YilunAllenChen/YingXao/README.md

# YingXao

Senior Capstone Design Project, Team Shouku  
ECE 4872  
Advisor: Linda Milor

## Project Documentation
All of our documentation is in a [CODA](https://coda.io/d/Senior-Design-Notebook_dczEd0e2DqA/Assignments_suUAO#_luX_1) page.
