YilunAllenChen/YingXao/YingXao_Expo/ece_server_version/download/projectsummary.docx

ECE 4871 Project Summary

Project Title | “YingXao 英招” Automatic EcoGardener

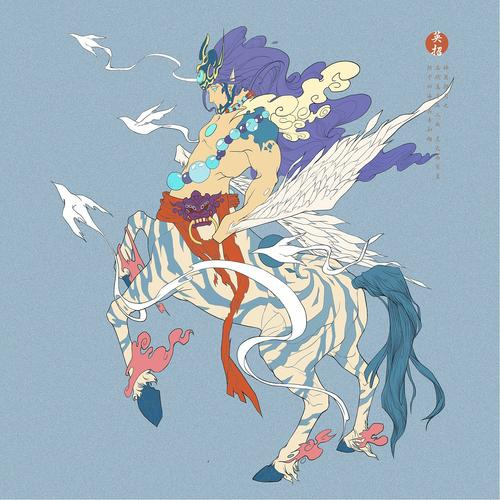
[picture p3: figure]

Project Logo
Team Members (names and majors) | Yihan Jiang (Computer Engineering)
| Yida Wang (Computer Engineering)
| Xi Li (Electrical Engineering)
| Yilun Chen (Computer Engineering)
Advisor / Section | Dr. Linda S Milor
Semester | Fall 2020 ECE 4871

Project Abstract

(250-300 words)

(10 point font, single spaced)

YingXao is embedded system design that can completely automate the process of taking care of the plant with a plan specifically tethered towards the needs of that particular species.

To achieve this, we need a low-cost low-power microcontroller unit that can sit near the vase with environment sensors (humidity, temperature, luminosity, etc) connected in order to monitor the status of the plant. We will build an internal water cycle to make save water resources and add required nutrition for plants(nitrogen, phosphorus, and potassium)

The system will be plugged into wall power and equipped with a rechargeable LiPo battery as a backup power source.

In addition, the microcontroller unit requires internet connection capabilities(Wifi module) in order to acquire data from our pre-established database where we store caring plans for different species of plants.

Microcontroller unit will be able to communicate with users through smartphone by a mobile-based UI

The end user of this product will be able to connect the device to WiFi, set the caring configuration from a web/mobile-based UI and enjoy the convenience of automatic plant caring brought by YingXao

Size of vase(Graph)

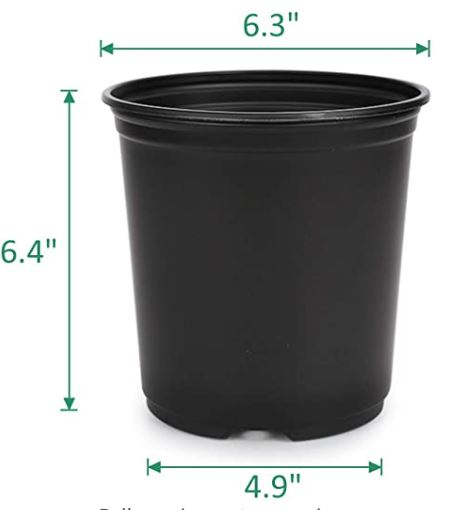
[picture p4: figure]

Figure 1. Size of plant

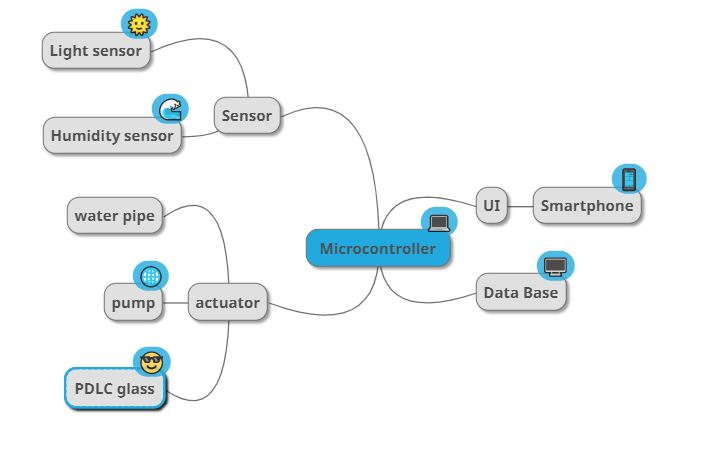
[picture p5: figure]

Figure 2. Structure of YingXao

Table of component

Component | Microcontroller | Humidity Sensor | Light Sensor | Rechargeable cells | AC Charger | Pots | Cover
Type | ESP8266 | DHT11 | 287-18001 | RCR 123A | 18650 | 07 gallon plastic pot | PDLC smart glass
Information URL | Here (https://www.espressif.com/en/products/socs/esp8266) | Here (https://www.adafruit.com/product/386) | Here (https://www.newark.com/mcm/287-18001/sensing-range-max-7m/dp/25AC5060) | Here (https://www.ebay.com/itm/8-Slot-Fast-Battery-Charger-for-Rechargeable-4-2V-Lithium-ion-RCR123A-Batteries/202795161641) | Here (https://www.joom.com/en/products/5df4b2aa28fc710101a0093c) | Here (https://www.amazon.com/GROWNEER-Container-Seedlings-Vegetables-Succulents/dp/B07QTJ1D3K) | Here (https://www.banggood.com/20x30cm-Electronic-PDLC-Smart-Glass-EGlass-Switchable-Emagic-Electroch-Film-p-1109872.html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)

Project Title
List codes and standards that significantly affect your project. Briefly describe how they influenced your design. | (10 point font, single spaced) - Institute of Electrical and Electronic Engineers (IEEE) - Coordinated with ANSI, ETSI and other standards organizations (e.g. IEEE/ANSI N42) - IEEE 802.xx standards are most cited and concentrate on telecommunications - IEEE 1666 standards concentration on software - Environmental Protection Agency (EPA), Occupational Safety and Health Administration (OSHA), Consumer Product Safety Commission (CPSC)
List at least two significant realistic design constraints that applied to your project. Briefly describe how they affected your design. | (10 point font, single spaced) 1) Power consumption 2) Size and cost of battery: the solar panel is environmentally-friendly but relatively expensive for a vase. It is important to choose a cheaper one, such as the lithium battery. 3) Glass filter for sunlight: we need to carefully choose the color of the outside cover in order to accommodate the individual sunlight requirements of plants.
Briefly explain two significant trade-offs considered in your design, including options considered and the solution chosen. | (10 point font, single spaced) Higher price will make project more effective but less attractive for potential customers More powerful MCU’s (Like Raspberry) provide additional functionalities and comparative ease to use, but are more power-hungry and costly.
Briefly describe the computing aspects of your projects, specifically identifying hardware-software tradeoffs, interfaces, and/or interactions. Complete if applicable; required if team includes CmpE majors. | (10 point font, single spaced) - The MCU reads data from environment sensors - The MCU controls actuators to adjust humidity levels / luminosity levels, etc. - The MCU pulls data from a remote database - The MCU hosts a web page as an UI - The MCU supports sleep mode for low power. - The MCU uses RTOS.

Project Title
Leadership Roles (ECE4871 & Forecasted for ECE4872) (NOTE: ECE4872 requires definition of additional leadership roles including: 1.Webmaster 2. Expo coordinator 3. Documentation | ECE 4871 Hardware Lead: Yida Wang Software Lead: Yihan Jiang Project Manager: Xi Li Documentation Administrator : Yilun Chen ECE 4872 Documentation Coordinator: Yilun Chen Project Manager: Xi Li Webmaster: Yida Wang Expo Coordinator: Yihan Jiang
International Program: Global Issues (Less than one page) (Only teams with one or more International Program participants need to complete this section) | (10 point font, single spaced) N/A
