YilunAllenChen/YingXao/YingXao_Expo/ece_server_version/download/trpxili.docx

Xi Li

Linda S Milor

Shouku, team14

Comparison of Humidity Sensor Products

Humidity Measurement and Humidity Sensor

Introduction:

Sensors are devices that acquire physical, chemical, or biological quantitative information and convert them into readable signals. For every interactive device, sensors support devices to get information from the surrounding environment. Humidity measurement is one of the most important physical properties which are closely related to the A huge variety of manufacturing, storage and testing processes are humidity-critical. Humidity sensors are used wherever the industry needs to prevent condensation, corrosion or other products that need protection. The humidity measurement is highly related to food, chemical, wood processing, electrical systems, and more products. [1][8].

Humidity Sensors types:

Current humidity sensors can be divided into two categories, absolute humidity sensors and relative humidity sensors. Absolute Humidity(AH) is calculated by ratio of mass of water vapor in air to the volume of air, while the Relative Humidity(RH) is defined as ratio of the amount of moisture in the air to the saturated moisture level that air can hold at the same temperature and pressure condition.[7] In the market, relative humidity is more popular than absolute humidity because it is simpler to make and thus cheaper. There are more types of relative humidity sensors with technology development. Since 2005, relative humidity can be categorized into 3 types, ceramic, semiconductor and organic polymer types.[2] All these three types of sensors measure changes in the physical and electrical properties when the atmospheric humidity condition changed.The ceramic type of sensor based on metal oxides has several advantages compared to other types in thermal capability, physical stability, and resistance to chemical reaction. [2] Water vapour is normally invisible, and behaves like a gas[8], so the humidity measurement of hygrometer type of sensors measures humidity by electrical impedance, conductance, because of the adsorption of water molecules of Impedance-sensitive type material. For instance, the polyimide layers with different thickness and morphologies will change its capacitive with respect to change in humidity[3], so that the ceramic type humidity sensor has two types, resistive type and capacitive type.

Among different types of sensors discussed above, in general, ceramic and semiconductor type of humidity sensors usually cost lower than other types, but this type can’t take the polymer as sensing material. Thin or thick film fabrication processes can take the polymer as sensing material but they cost higher than ceramic fabrication.

Commercial applications of Humidity measurement technology:

Most products of humidity sensors in the market are relative humidity sensors. Here is the comparison between three of the most popular RH sensors for : HS1101LF, DHT11 and HIH-4000-001.

HS1101LF has the highest price-performance ratio. it has the cheapest which only costs $5.9, and it has a wider operating temperature range and storage temperature range, both -60 to 140 °C, compared to the other two. It also has the widest humidity measurement range, from 0% -100%RH.[4]

HIH-4000-001 has similar measurement and storage temperature range, but it has the highest price among these three sensors. HIH-4000-001 costs $23.34. However, it is resistive to chemical reaction. This sensor can work properly under most application hazards, such as dust, oil, or environmental chemicals.This characteristic allows HIH-4000-001 to be used in unideal working environments.[6]

Another competing product is DHT11. DHT11 has an immediate price, but it has a narrow range of operating temperature, storage temperature. Its humidity measurement range is also narrow, only from 20-90%RH. However, this sensor has an embedded 8-bit microcontroller so that it has compatibility with microcontroller products. It’s datasheet provides users with clear wire connection and its communication protocol. [5]

Implementation of capacitive RH sensors:

There are so many types of humidity sensors and each of them has a unique fabrication process, so discussion here will only include the most popular type, the capacitive RH sensor. There are two typical configurations of capacitive humidity sensors, a sandwiched structure with two electrode surfaces on each side, or an interdigitated structure with comb electrodes. The two metal electrodes are deposited on the substrate and coated with a thin film layer of a dielectric polymer or a porous ceramic metal oxide. In the sandwich configuration, the upper electrode is always a water vapour permeable film[9]. There is a humidity sensitive polymer between two electrodes. Lead wires will be connected to the lower electrode so that the changed signal can be transmitted through wires

[1] Drexhage, P. A. U. L. "Effect of humidity and condensation on power electronics systems." Semikron Application Note NA (2016): 16-001.

[2] Farahani, H., Wagiran, R. and Hamidon, M., 2020. Humidity Sensors Principle, Mechanism, And Fabrication Technologies: A Comprehensive Review.

[3] Boudaden, J., Steinmaßl, M., Endres, H., Drost, A., Eisele, I., Kutter, C. and Müller-Buschbaum, P., 2020. Polyimide-Based Capacitive Humidity Sensor.

[4] TE Connectivity, “Relative Humidity Sensor”, HS1101LF Datasheet, September 2015 [Online]. Available: https://www.te.com/commerce/DocumentDelivery/DDEController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

[5] Adafruit, “Humidity and Temperature Sensor”, DHT11 Datasheet, September 2020 [Online]. Available: https://www.osepp.com/downloads/pdf/DHT11-Technical-Data-Sheet-Translated-Version.pdf

[6] [4]Alliedelec.com, 2020. [Online]. Available: https://www.alliedelec.com/m/d/366682f71f67784981f9126133e1d1b1.pdf. [Accessed: 09- Oct- 2020].

[7]"Humidity measurement", Slideshare.net, 2020. [Online]. Available: https://www.slideshare.net/MohitSinghRajput/humidity-measurement. [Accessed: 09- Oct- 2020].

[8]S. Bell,”The Beginner’s Guide to Humidity”, Rotronic.com, 2012. [Online]. Available: https://www.rotronic.com/media/productattachments/files/b/e/beginners_guide_to_humidity_measurement_v0_1.pdf. [Accessed: 09- Oct- 2020].

[9]R. Fenner and E. Zdankiewicz, "Micromachined water vapor sensors: a review of sensing technologies," in IEEE Sensors Journal, vol. 1, no. 4, pp. 309-317, Dec. 2001, doi: 10.1109/7361.983470.
