YilunAllenChen/YingXao/YingXao_Expo/ece_server_version/download/proposalpresentation.pdf

# “YingXao” Automatic EcoGardener

ECE 4872 Senior Design Project Proposal Presentation

Presenter: Yilun Chen, Yida Wang, Xi Li, Yihan Jiang

# Meet Our Team

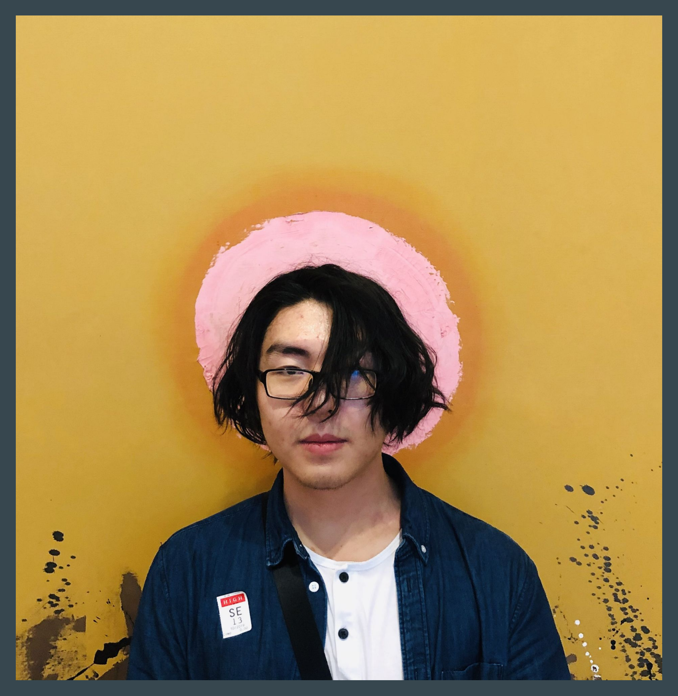
[picture p6: figure]
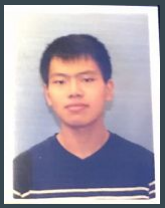
[picture p7: figure]

Hardware Lead: Yida Wang

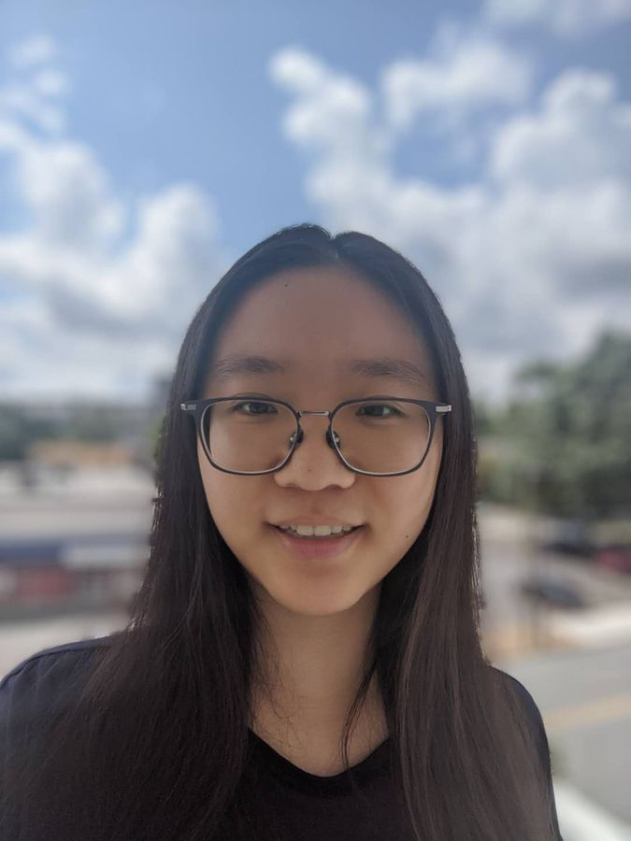
[picture p8: figure]
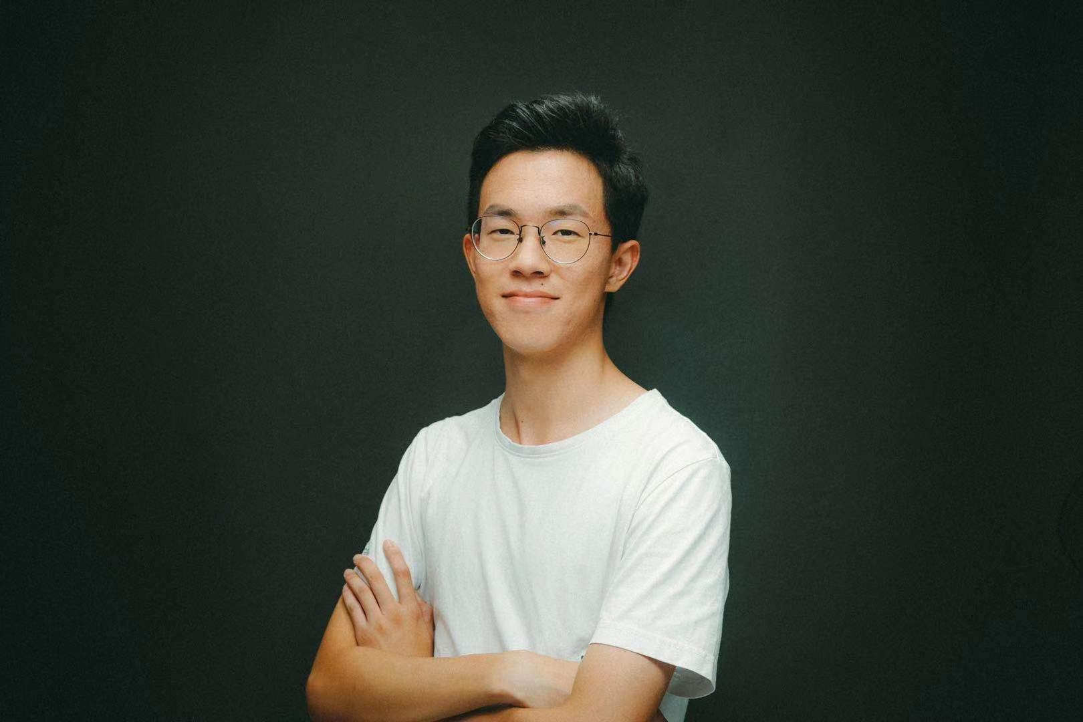
[picture p9: figure]

Software Lead: Yihan Jiang | Project Manager: Xi Li

# Motivation

### - Smart Gardening - Existing products:

- Too expensive : $2,500+ per unit
- Use artificial lighting. Not env-friendly
- Too big. Not portable

### - We also want it to:

- Constantly improve its gardening plans

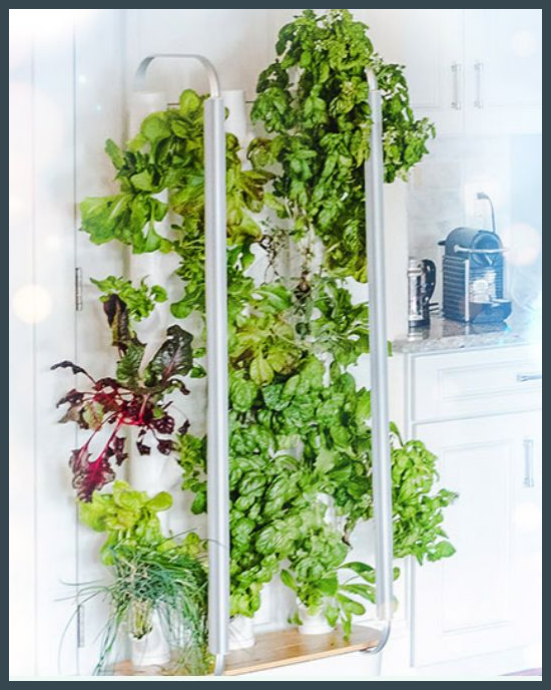
[picture p10: figure]

- Better user-plant interaction | https://mygardyn.com/

# 30,000 Ft High-level Design

### - Interplay of software and hardware

- Physical Device
- Interact with sensors and actuators
- Cloud Service
- Provides gardening plans
- App
- Provides an interaction/monitoring interface

### - Project goals

- Users don’t need to take care of the plants themselves
- Smooth and easy setup workflow
- Unit cost below $100

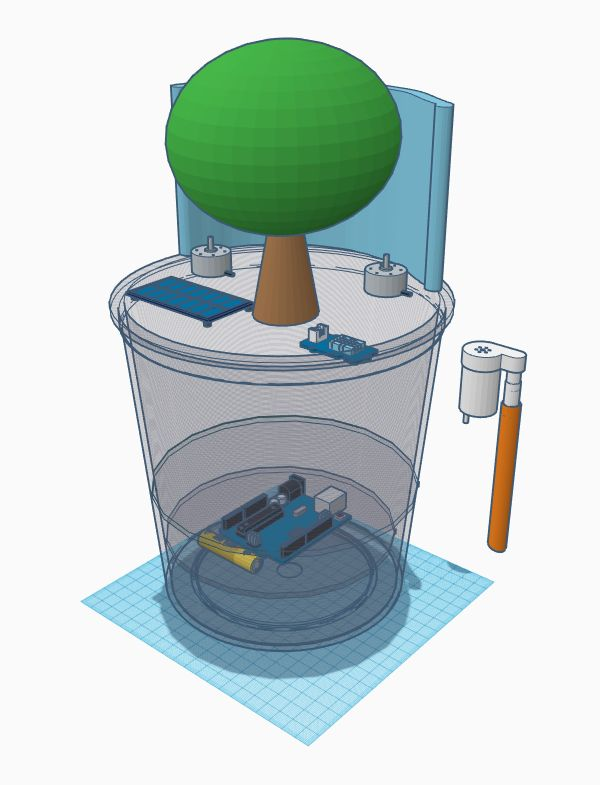
[picture p11: figure]

Picture: Conceptual Design of YingXao

# Tech Specs

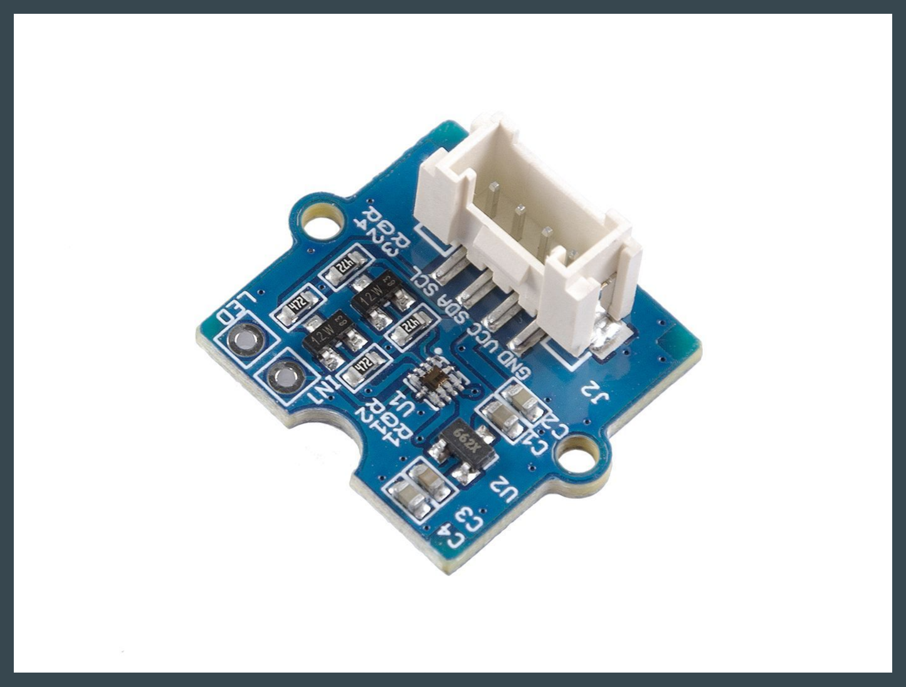
[picture p12: figure]

### - Raspberry Pi Zero W

- Fast processing speed, low cost and high compatibility
- Bluetooth and internet

### - DHT11 basic temperature-humidity sensor

- Ultra low cost and simply

### - Grove - Sunlight Sensor

- Wide spectrum detection range and detect sunlight directly

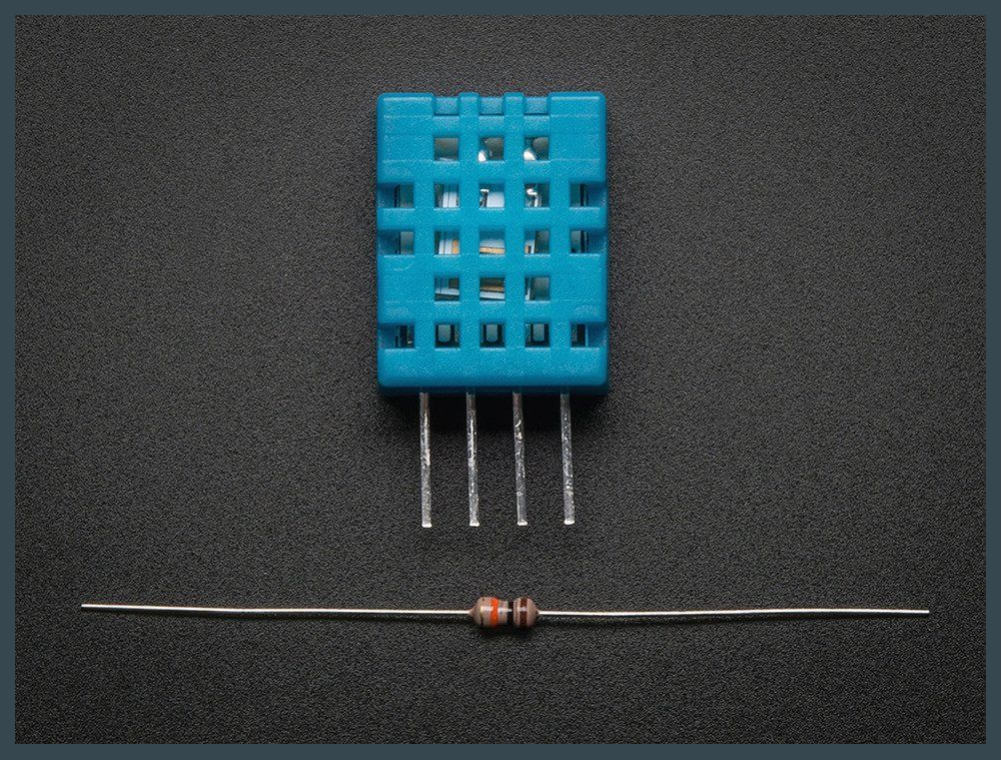
[picture p13: figure]
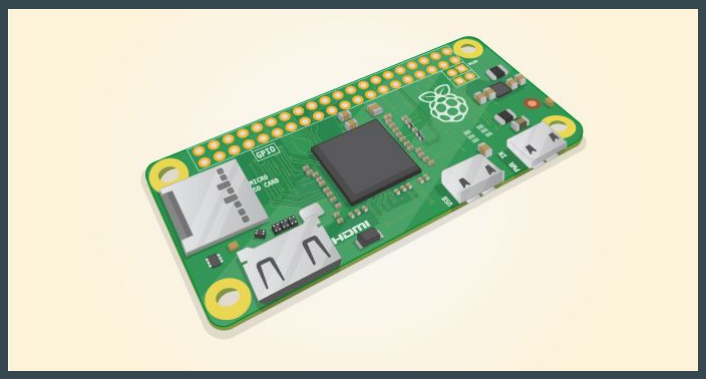
[picture p14: figure]

# Design Approach

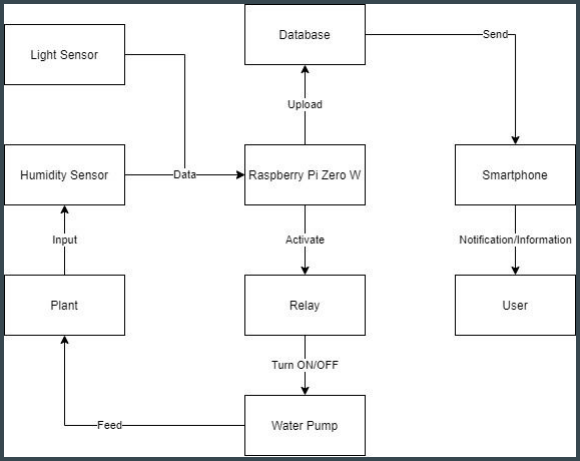
[picture p15: figure]

### - Sensing

### Light and Humidity

### - Control

### Pump and light blocking

### - Communication

### Pi zero and App

# Conceptual UI of App

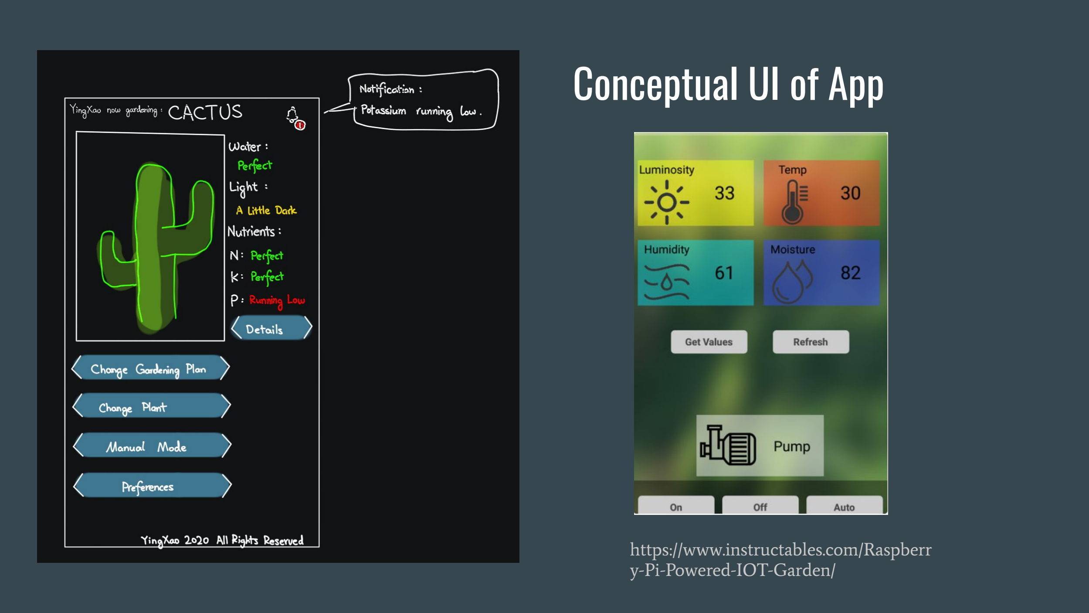
[picture p16: page 7]

https://www.instructables.com/Raspberry-Pi-Powered-IOT-Garden/

# Cost

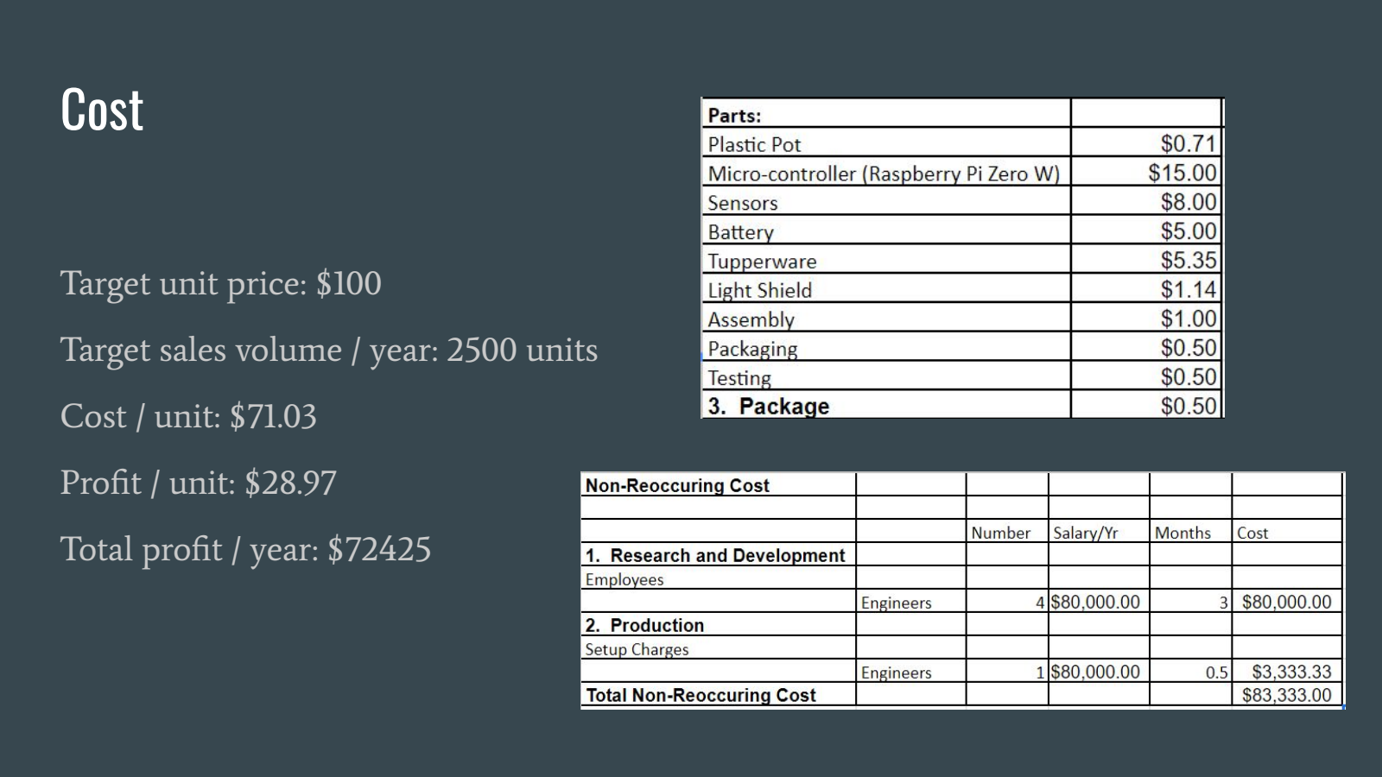
[picture p17: page 8]

### Target unit price: $100 Target sales volume / year: 2500 units Cost / unit: $71.03 Profit / unit: $28.97 Total profit / year: $72425

# Schedules and Milestones

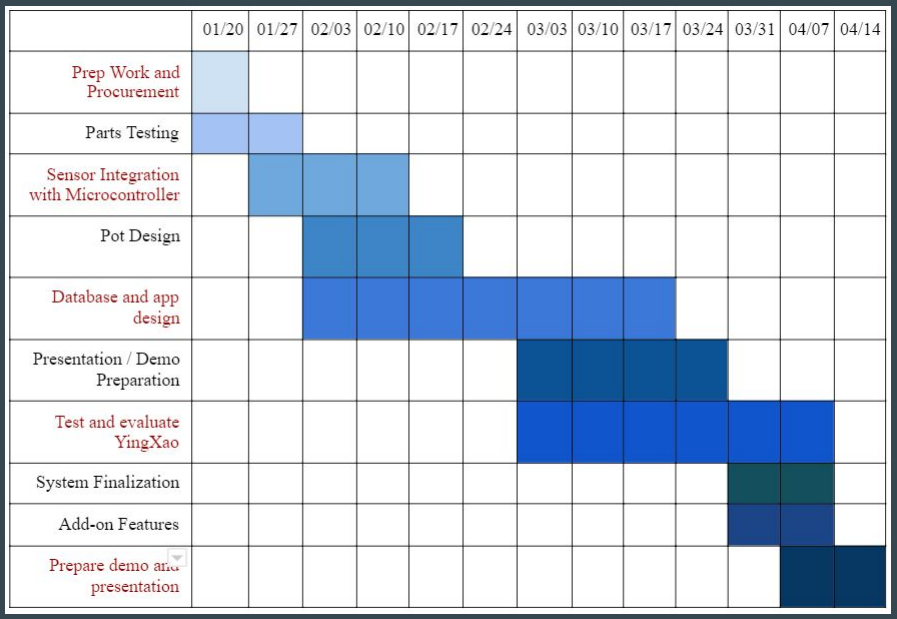
[picture p18: figure]

# Critical Path

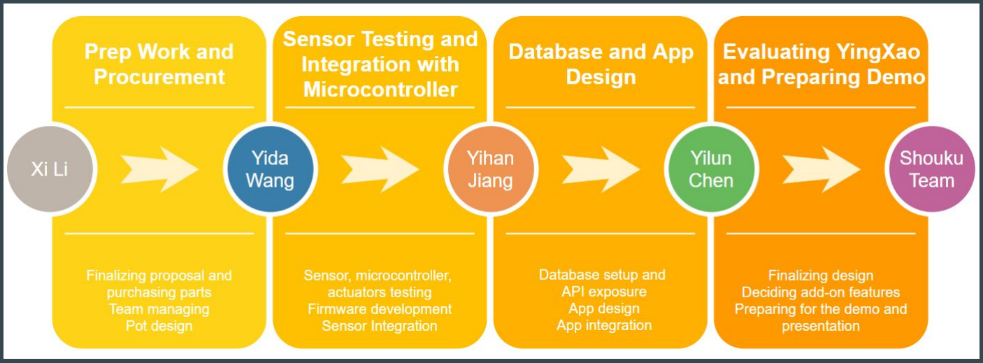
[picture p19: figure]

# Project Demo

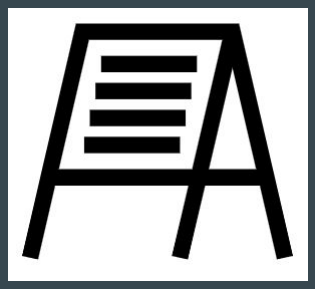
[picture p20: figure]
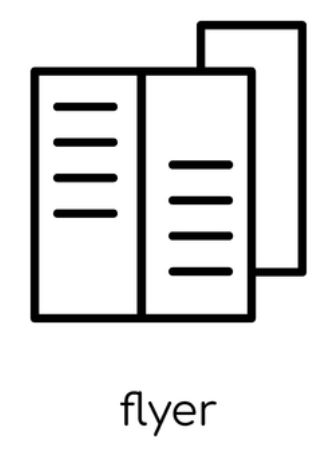
[picture p21: figure]

https://eu.clipdealer.com/vector/media

- What will we present?
Physical body of the gardener & the app that monitors the gardener
- How will we present?
Poster, Flyer -> Design overview and concept map Live demonstration -> Specific functions
1. App Setting
2. Sensor Reading
3. Pump and Light Shielding

# Thank you!
