YilunAllenChen/YingXao/YingXao_Software/Block Diagram.pdf

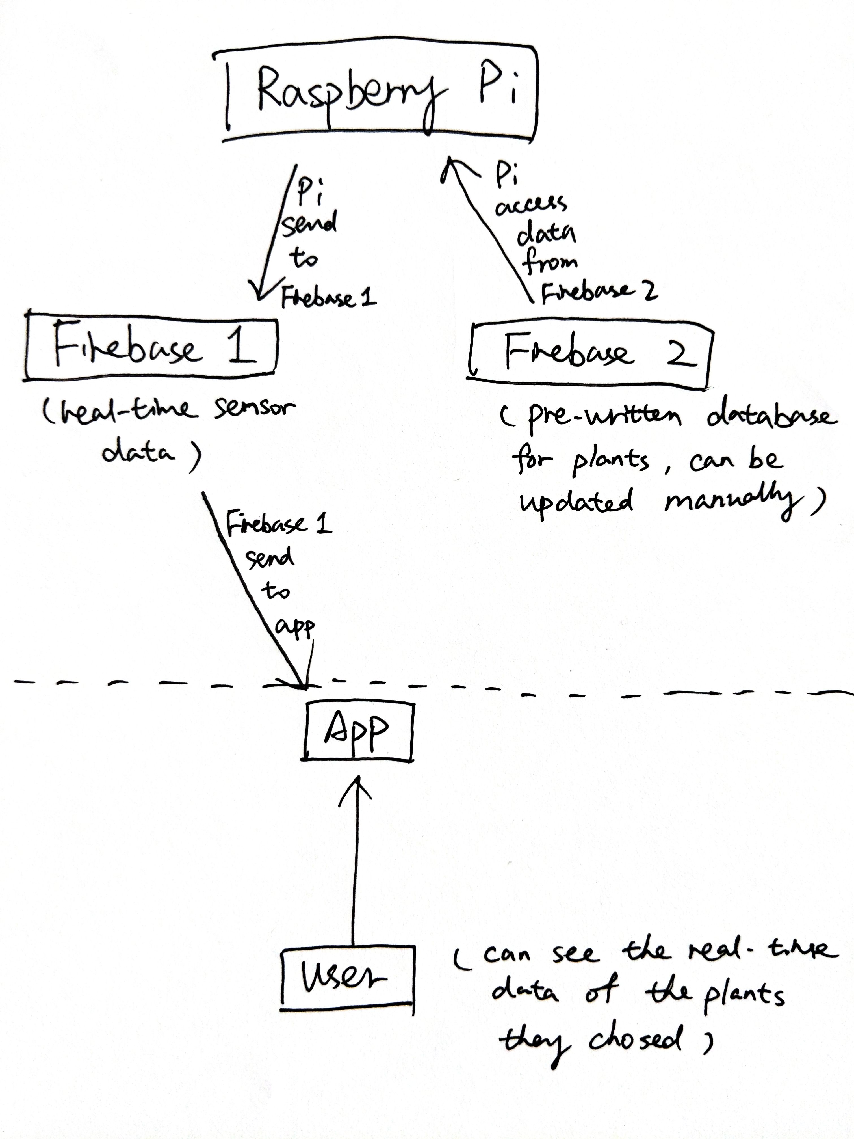
[picture p22: page 1]
