YilunAllenChen/YingXao/YingXao_Expo/ece_server_version/3dprinting.png

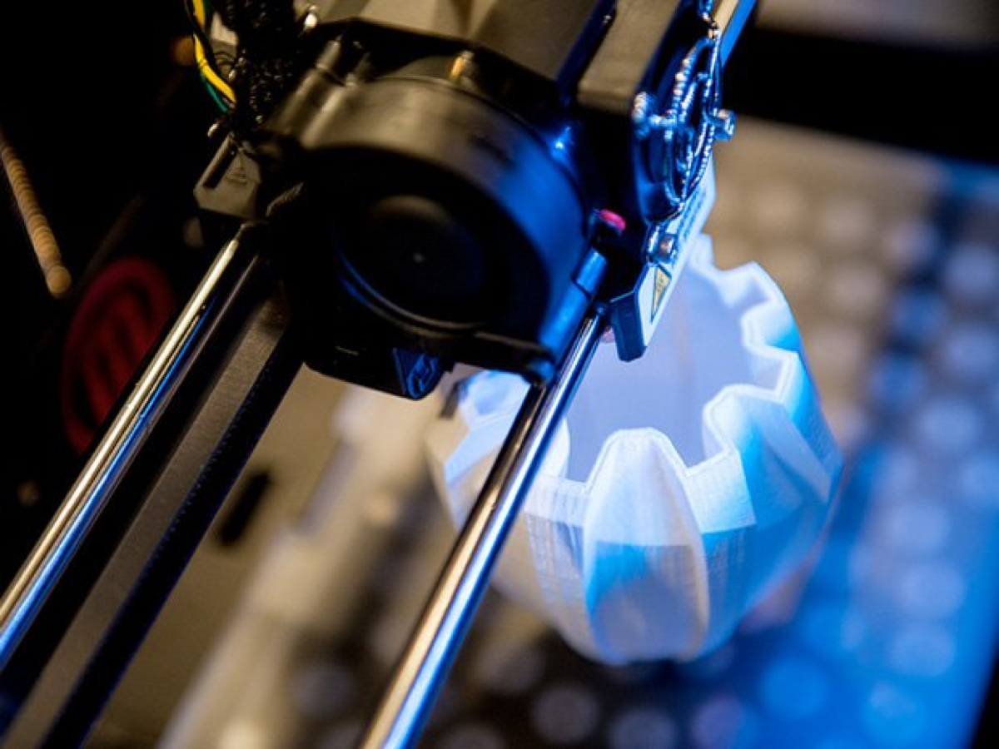
YingXao_Expo/ece_server_version/3dprinting.png
