YilunAllenChen/YingXao/YingXao_Expo/ece_server_version/3dprinting_wallpaper.jpg

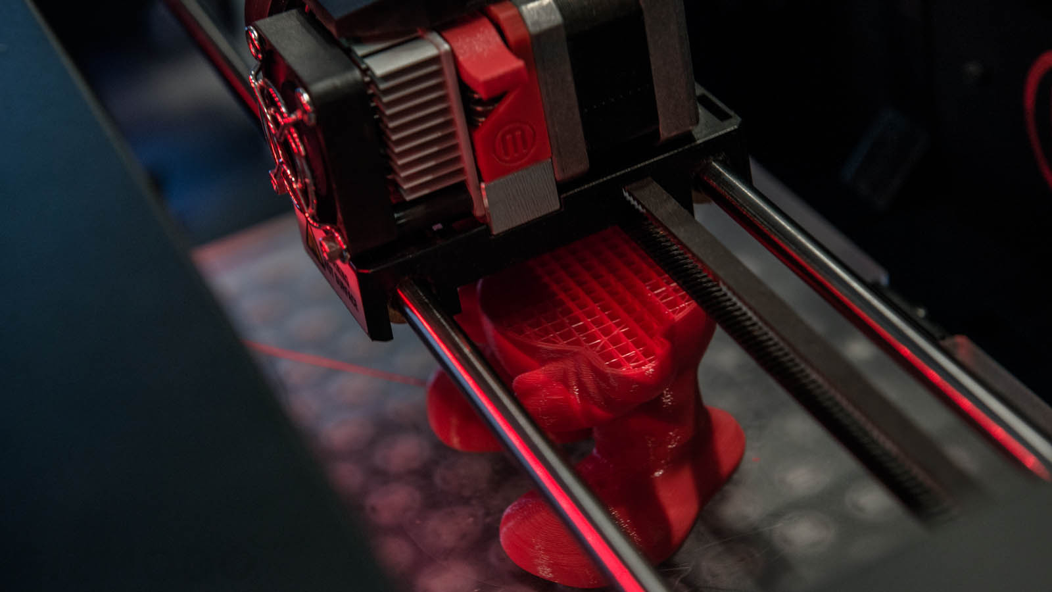
YingXao_Expo/ece_server_version/3dprinting_wallpaper.jpg
