YilunAllenChen/YingXao/YingXao_Expo/ece_server_version/black_backpack.jpg

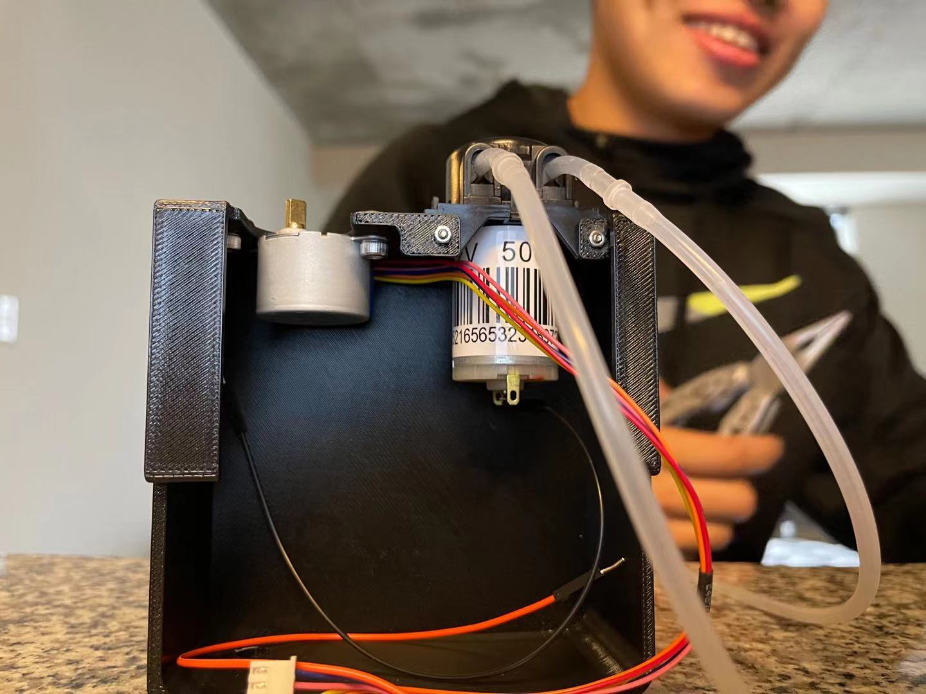
YingXao_Expo/ece_server_version/black_backpack.jpg
