YilunAllenChen/YingXao/YingXao_Expo/ece_server_version/cloud_computing.jpg

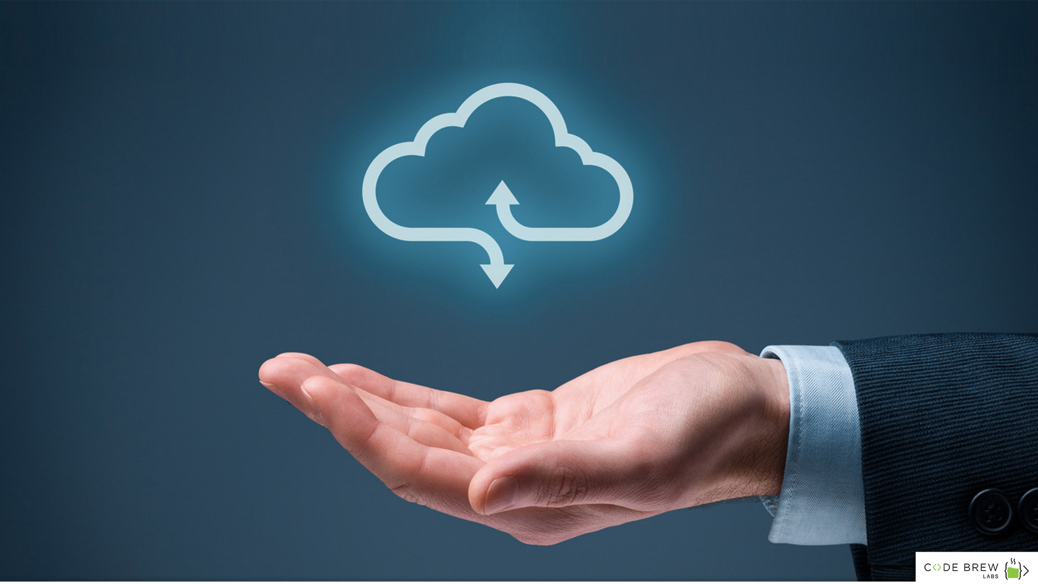
YingXao_Expo/ece_server_version/cloud_computing.jpg
