YilunAllenChen/YingXao/YingXao_Expo/ece_server_version/cloudcomputing.jpg

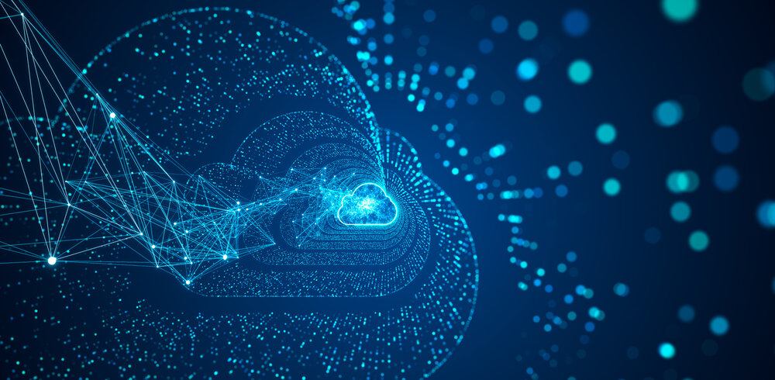
YingXao_Expo/ece_server_version/cloudcomputing.jpg
