YilunAllenChen/YingXao/YingXao_Expo/ece_server_version/cross_platform.png

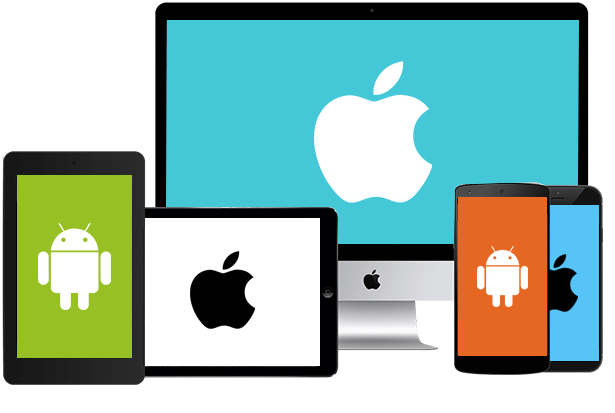
YingXao_Expo/ece_server_version/cross_platform.png
