YilunAllenChen/YingXao/YingXao_Expo/ece_server_version/download_center.jpg

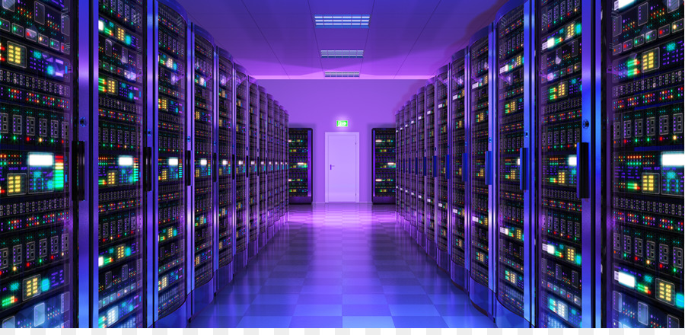
YingXao_Expo/ece_server_version/download_center.jpg
