YilunAllenChen/YingXao/YingXao_Expo/ece_server_version/electronics.jpg

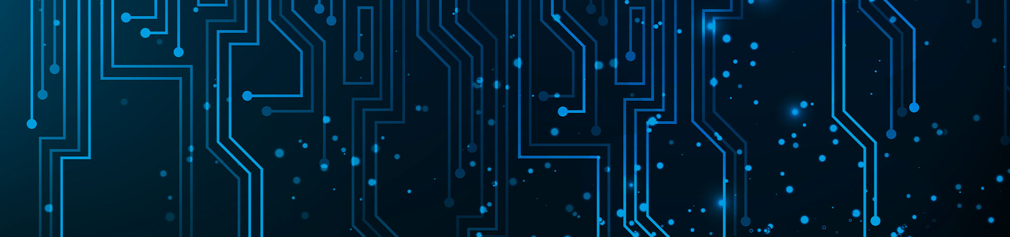
YingXao_Expo/ece_server_version/electronics.jpg
