YilunAllenChen/YingXao/YingXao_Expo/ece_server_version/electronics.png

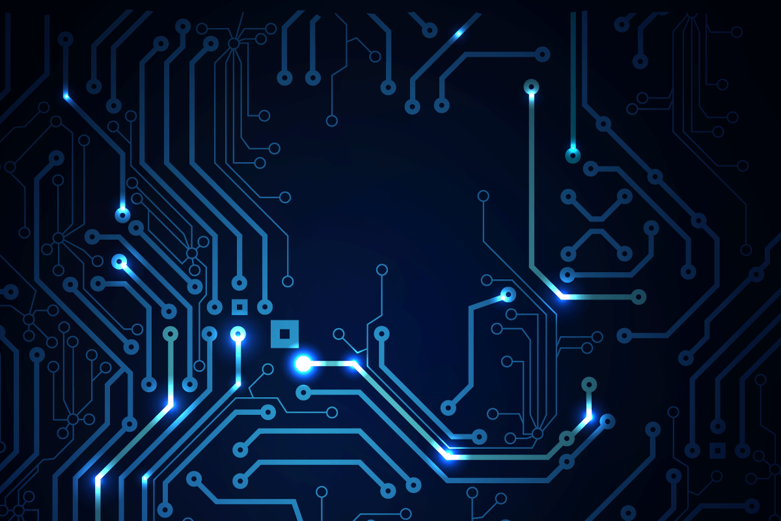
YingXao_Expo/ece_server_version/electronics.png
