YilunAllenChen/YingXao/YingXao_Expo/ece_server_version/embedded.jpg

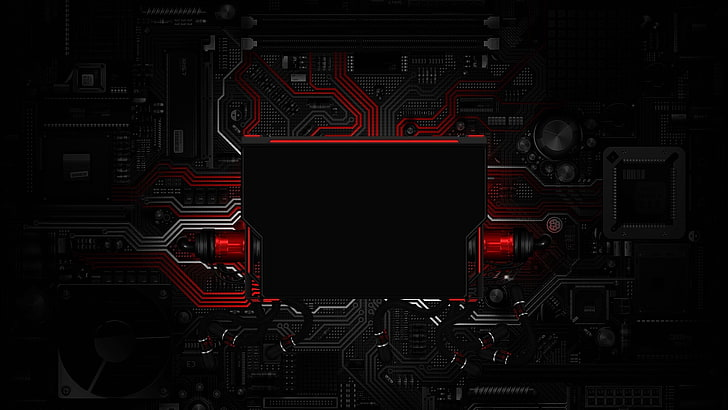
YingXao_Expo/ece_server_version/embedded.jpg
