YilunAllenChen/YingXao/YingXao_Expo/ece_server_version/mobile_app.jpg

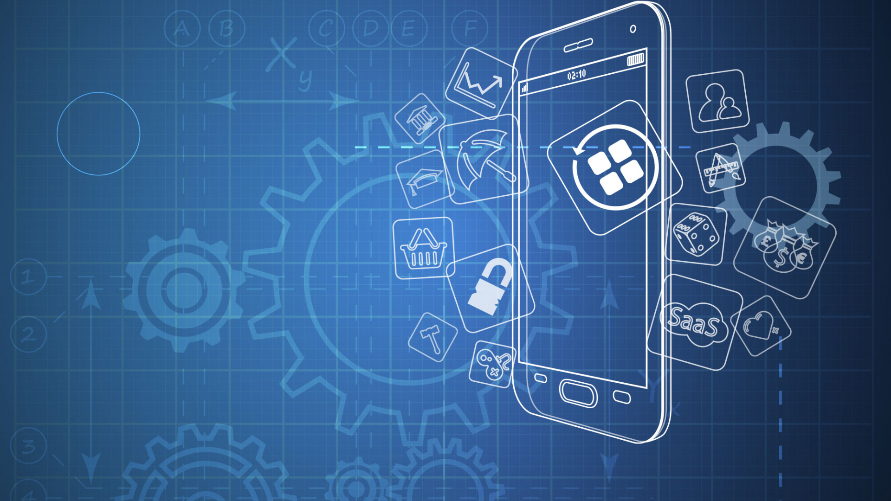
YingXao_Expo/ece_server_version/mobile_app.jpg
