YilunAllenChen/YingXao/YingXao_Expo/ece_server_version/presentation_cover.png

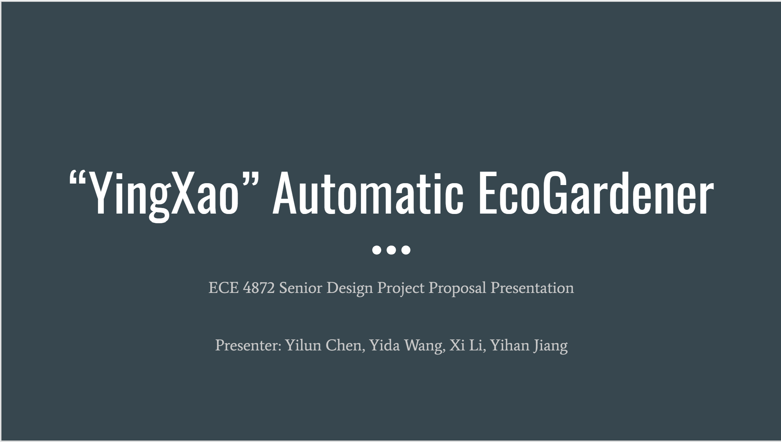
YingXao_Expo/ece_server_version/presentation_cover.png
