YilunAllenChen/YingXao/YingXao_Expo/ece_server_version/sensors.jpg

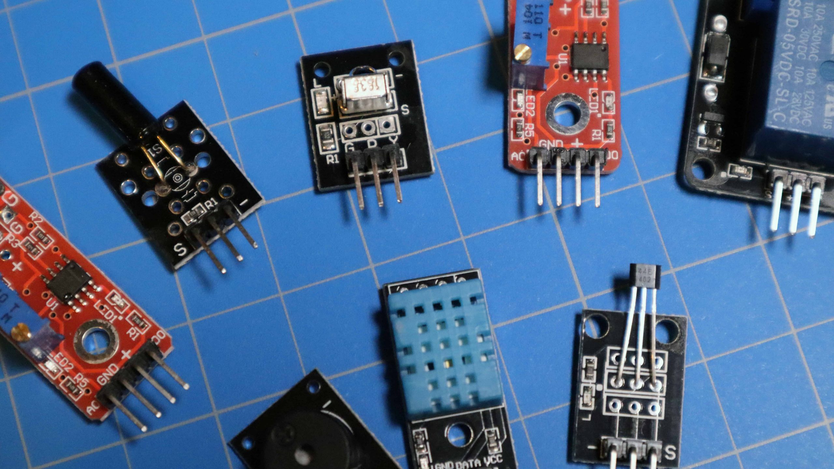
YingXao_Expo/ece_server_version/sensors.jpg
