YilunAllenChen/YingXao/YingXao_Expo/ece_server_version/sw_arch.png

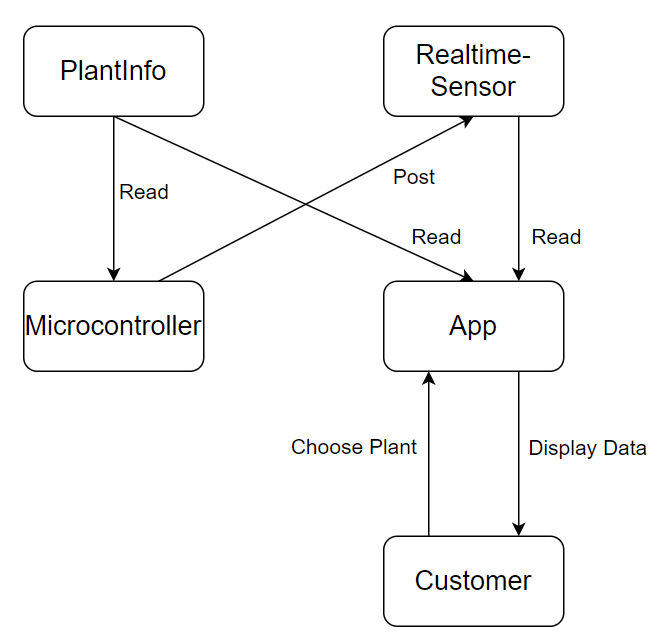
YingXao_Expo/ece_server_version/sw_arch.png
