YilunAllenChen/YingXao/YingXao_Expo/ece_server_version/sw_workflow.png

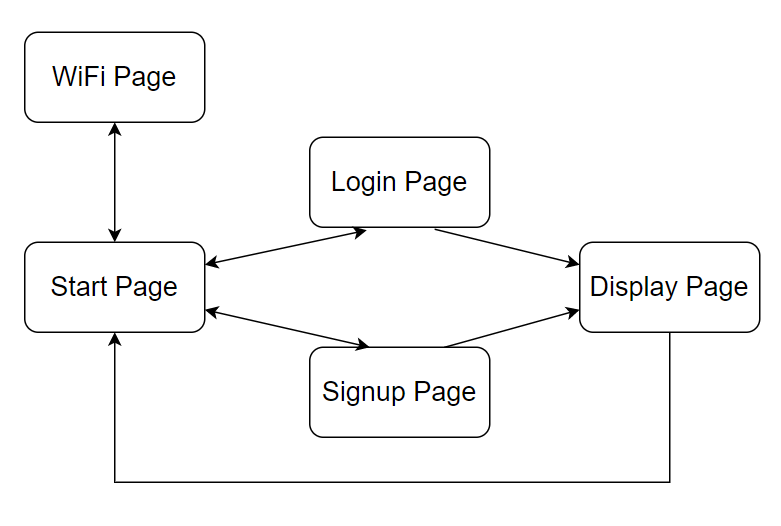
YingXao_Expo/ece_server_version/sw_workflow.png
