YilunAllenChen/YingXao/YingXao_Expo/ece_server_version/team.jpg

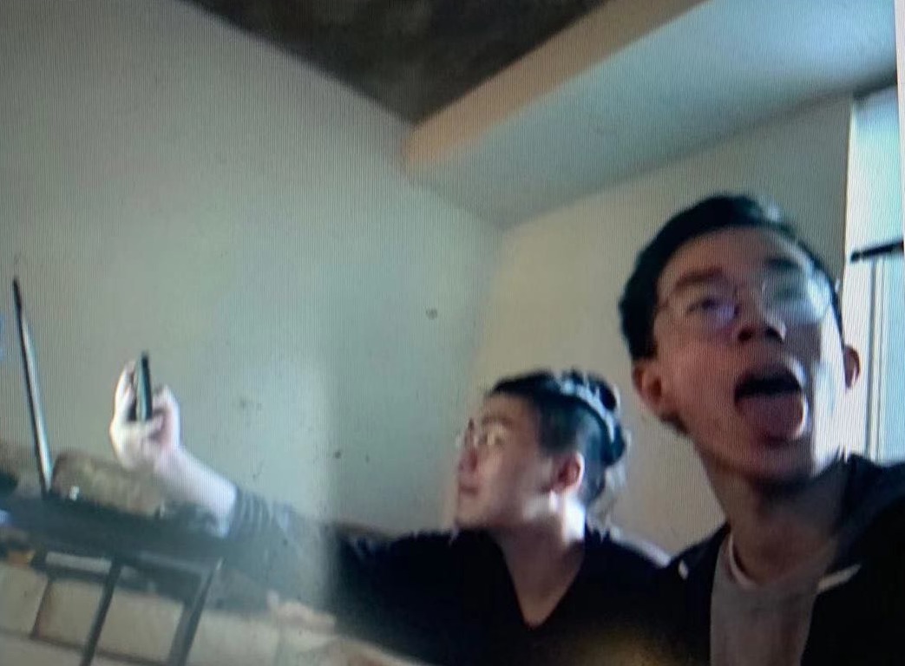
YingXao_Expo/ece_server_version/team.jpg
