YilunAllenChen/YingXao/YingXao_Expo/ece_server_version/yihan.png

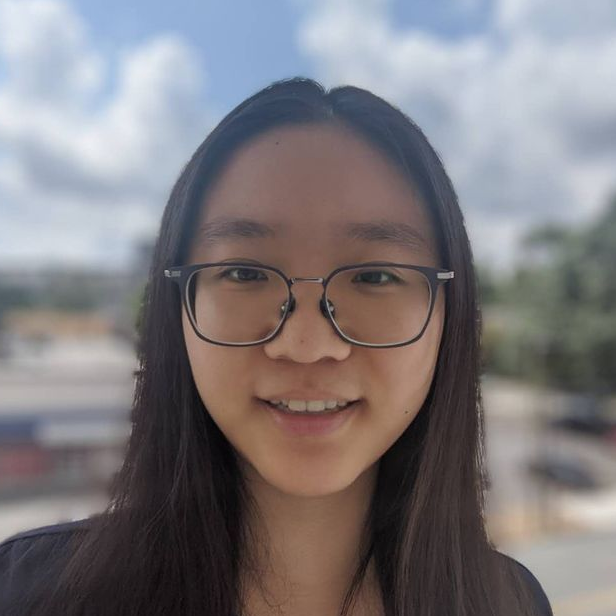
YingXao_Expo/ece_server_version/yihan.png
