YilunAllenChen/YingXao/YingXao_Expo/ece_server_version/yilun.jpg

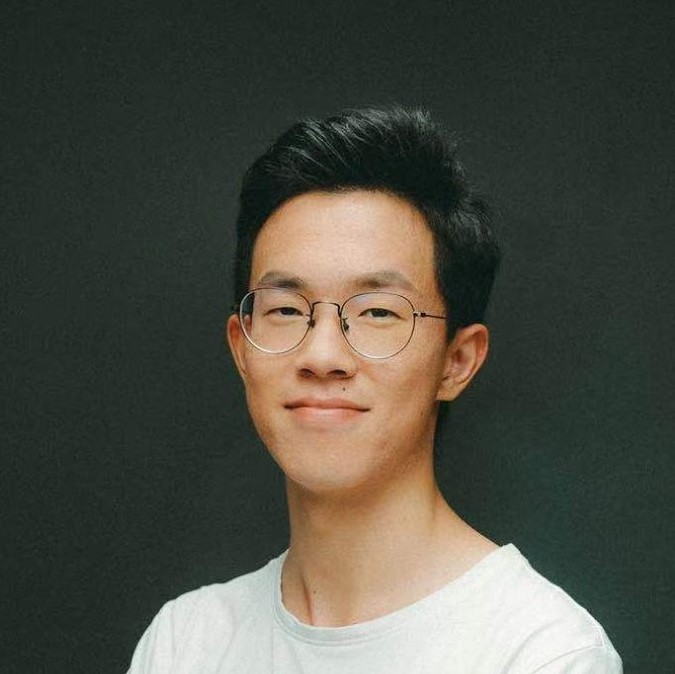
YingXao_Expo/ece_server_version/yilun.jpg
