YilunAllenChen/YingXao/YingXao_Expo/ece_server_version/yingxao_app_wifi.PNG

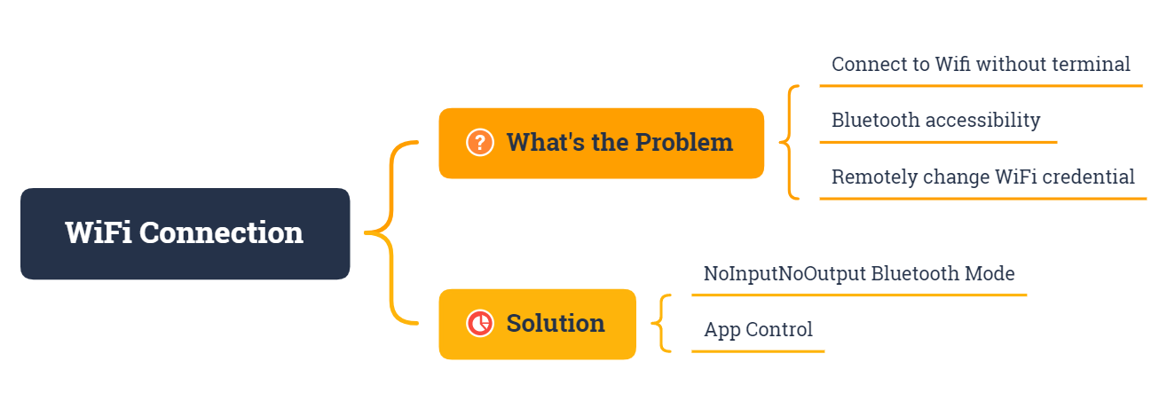
YingXao_Expo/ece_server_version/yingxao_app_wifi.PNG
