YilunAllenChen/YingXao/YingXao_Mechanical/Printable/SolarPanel_v1.stl

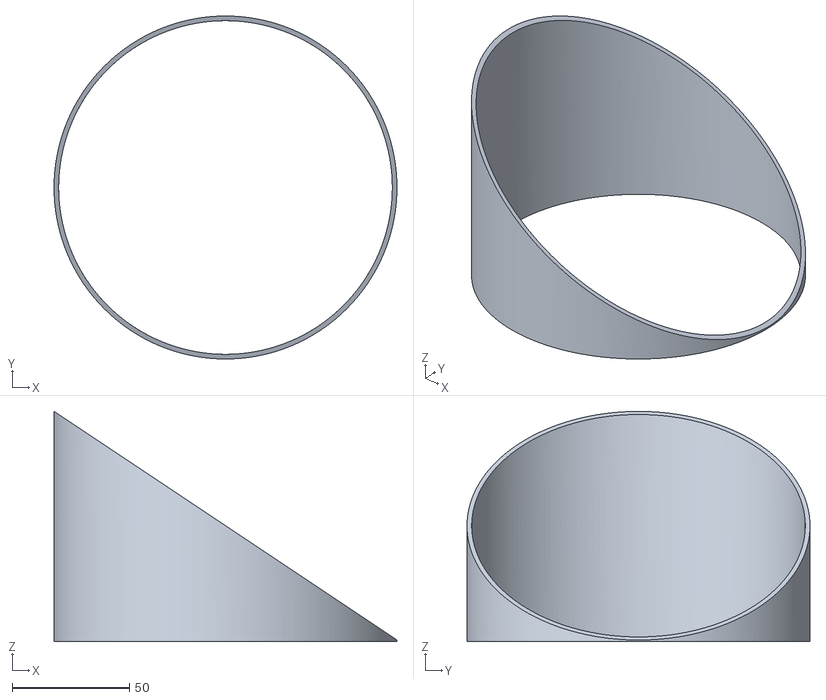
[picture p48: CAD file, 2021-03-14]
YingXao_Mechanical/Printable/SolarPanel_v1.stl
146.0 x 146.0 x 98.0
