YilunAllenChen/YingXao/YingXao_Mechanical/Printable/SolarGearRingWithBlind.stl

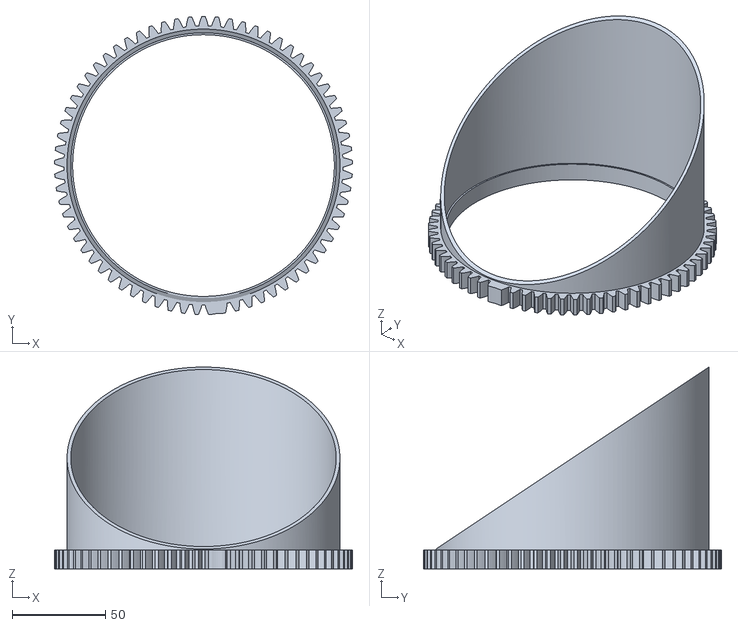
[picture p49: CAD file, 2021-03-14]
YingXao_Mechanical/Printable/SolarGearRingWithBlind.stl
159.5 x 159.5 x 108.0
