YilunAllenChen/YingXao/YingXao_Mechanical/Printable/SolarGearDriver_v13.stl

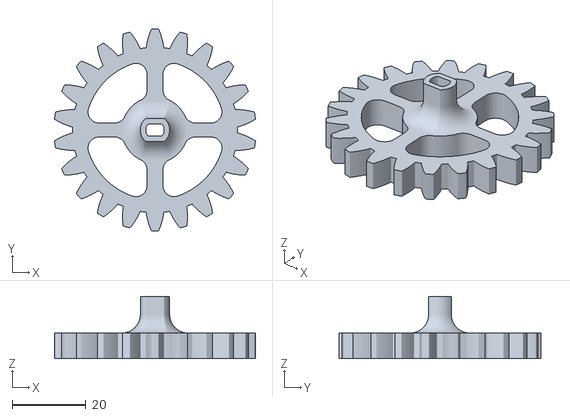
[picture p50: CAD file, 2021-03-14]
YingXao_Mechanical/Printable/SolarGearDriver_v13.stl
54.7 x 55.0 x 17.0
