YilunAllenChen/YingXao/YingXao_Mechanical/Printable/SolarGearBearing_v6.stl

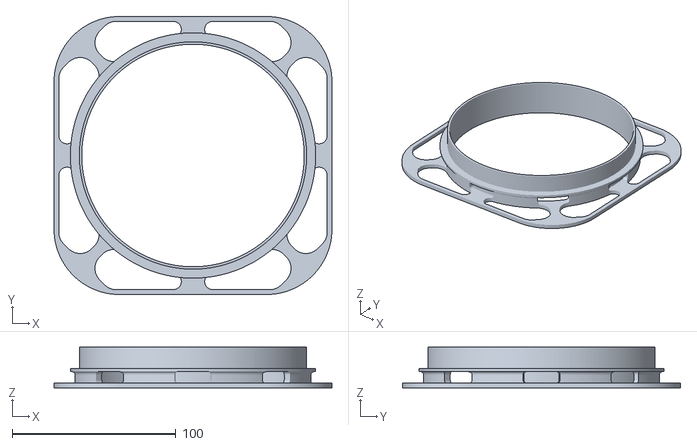
[picture p51: CAD file, 2021-03-14]
YingXao_Mechanical/Printable/SolarGearBearing_v6.stl
170.0 x 170.0 x 25.0
