YilunAllenChen/YingXao/YingXao_Mechanical/Printable/UniversalMount_v5.stl

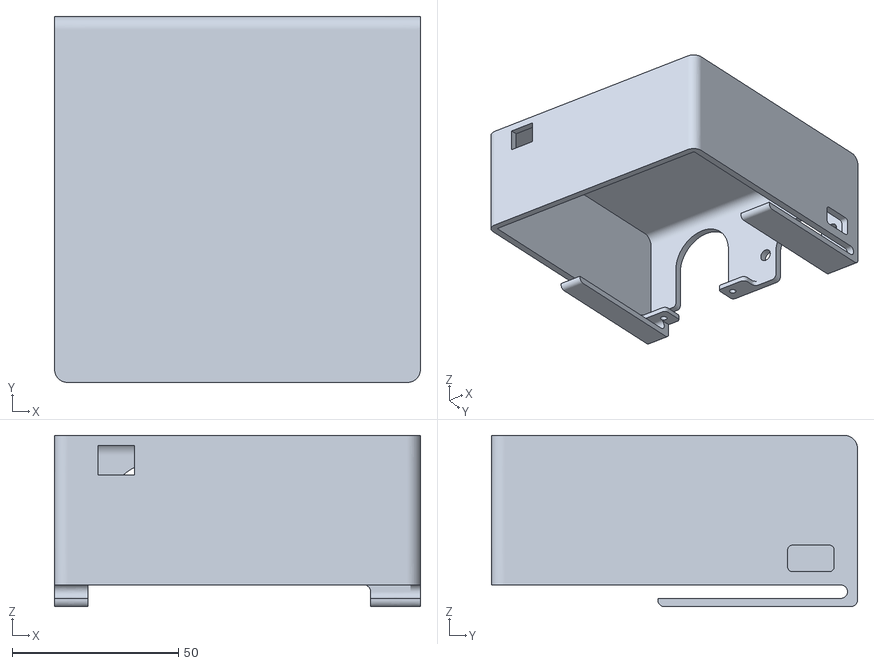
[picture p52: CAD file, 2021-03-14]
YingXao_Mechanical/Printable/UniversalMount_v5.stl
110.0 x 110.0 x 51.5
