YilunAllenChen/YingXao/YingXao_Mechanical/Printable/SolarGearRing_v7.stl

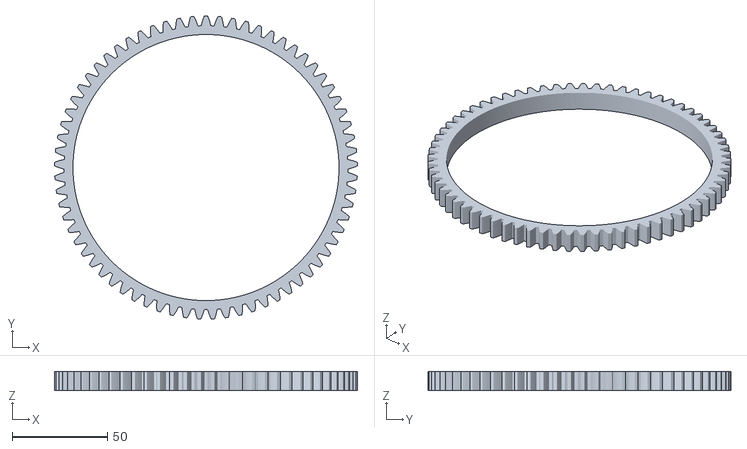
[picture p53: CAD file, 2021-03-02]
YingXao_Mechanical/Printable/SolarGearRing_v7.stl
159.5 x 159.5 x 10.0
