YilunAllenChen/YingXao/YingXao_Mechanical/Printable/MotorMount_v3.stl

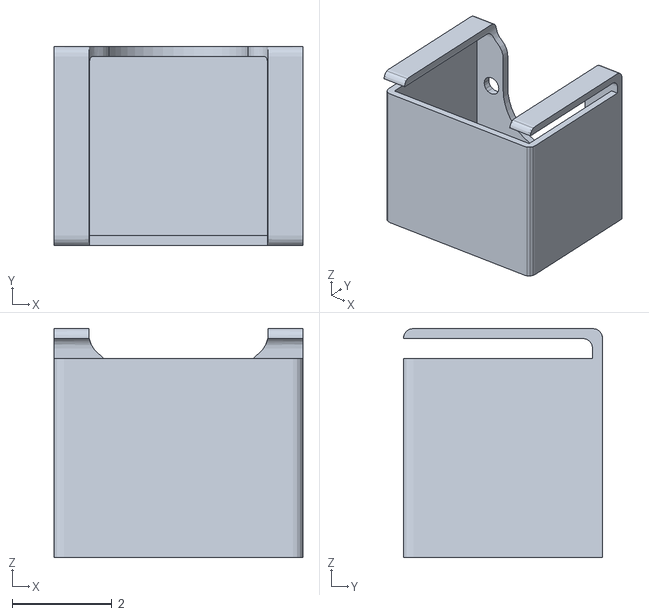
[picture p54: CAD file, 2021-02-09]
YingXao_Mechanical/Printable/MotorMount_v3.stl
5.00 x 4.00 x 4.60
