YilunAllenChen/YingXao/YingXao_Mechanical/Printable/SolarGear.stl

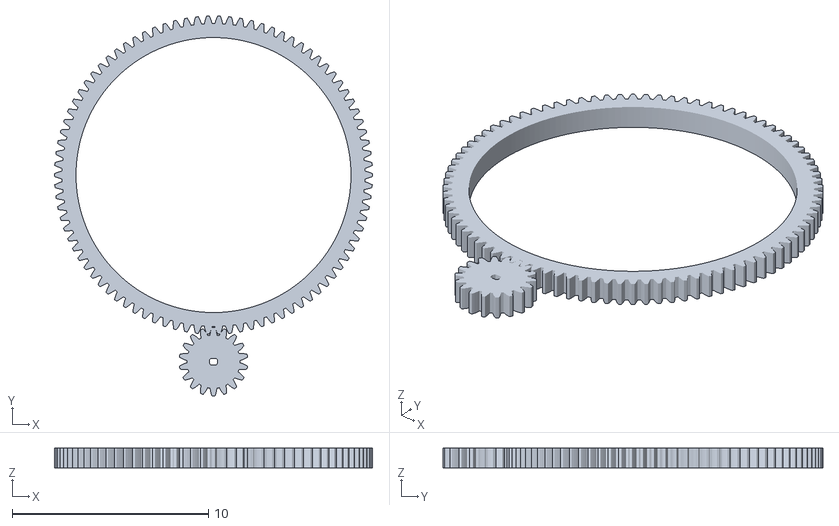
[picture p55: CAD file, 2021-02-07]
YingXao_Mechanical/Printable/SolarGear.stl
16.2 x 19.3 x 1.00
