YilunAllenChen/YingXao/YingXao_Mechanical/Printable/backpack_v1.stl

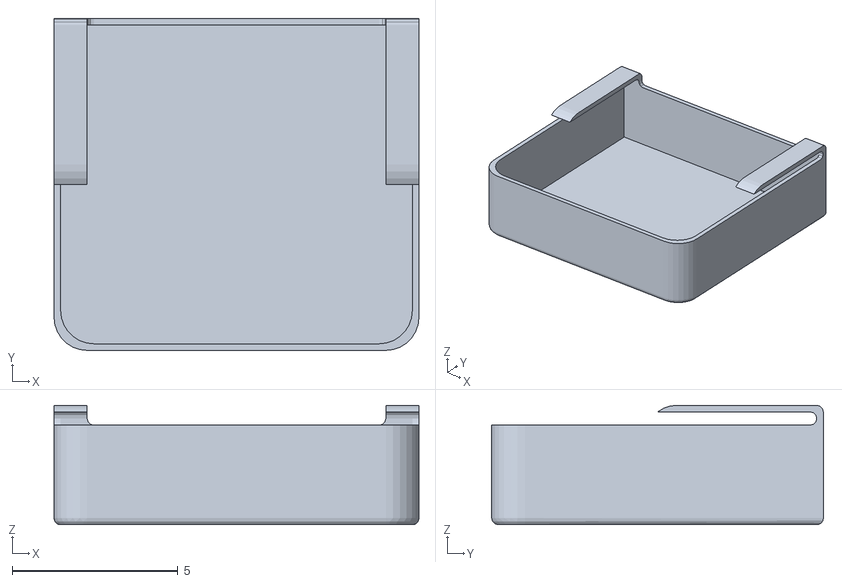
[picture p56: CAD file, 2021-02-07]
YingXao_Mechanical/Printable/backpack_v1.stl
11.0 x 10.0 x 3.60
