YilunAllenChen/YingXao/YingXao_Mechanical/Printable/Banzi2.stl

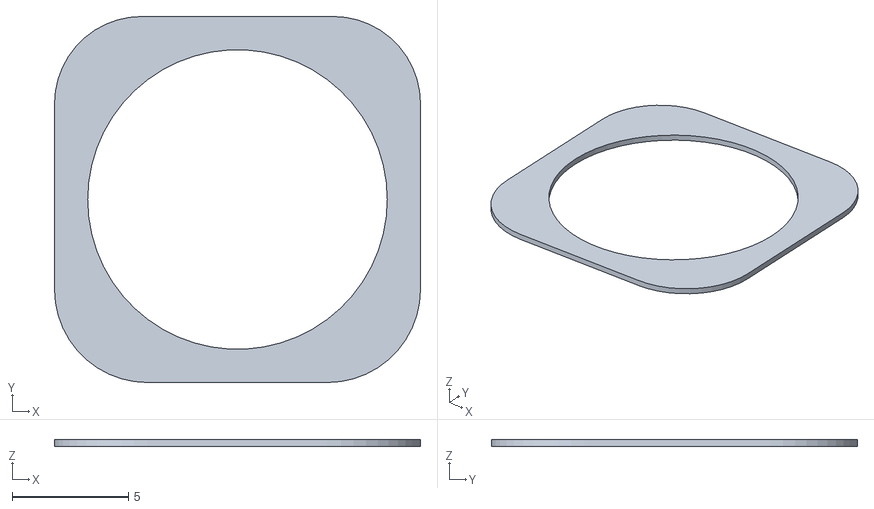
[picture p57: CAD file, 2021-02-06]
YingXao_Mechanical/Printable/Banzi2.stl
15.8 x 15.8 x 0.3
