YilunAllenChen/YingXao/YingXao_Mechanical/Printable/backpack_prototype.stl

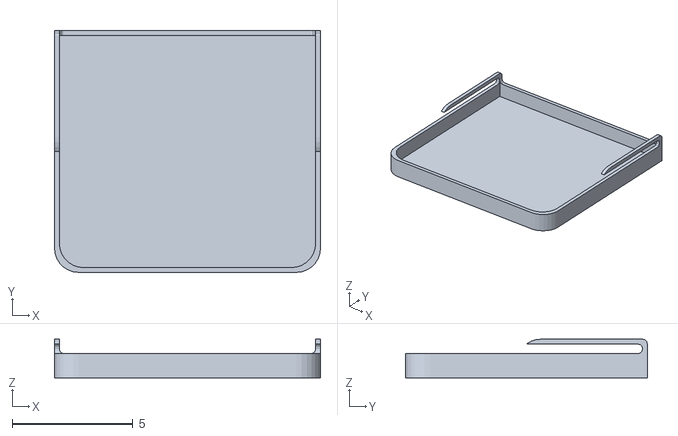
[picture p58: CAD file, 2021-02-06]
YingXao_Mechanical/Printable/backpack_prototype.stl
11.0 x 10.0 x 1.60
