YilunAllenChen/YingXao/YingXao_Mechanical/Printable/Banzi1.stl

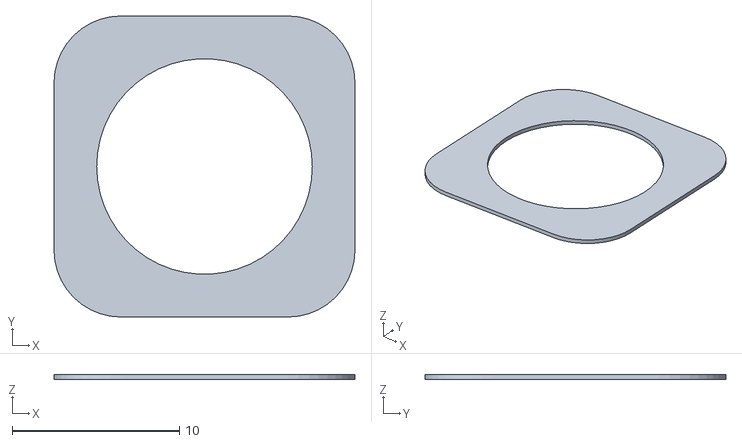
[picture p59: CAD file, 2021-02-06]
YingXao_Mechanical/Printable/Banzi1.stl
18.0 x 18.0 x 0.3
