YilunAllenChen/YingXao/YingXao_Mechanical/Printable/Banzi3.stl

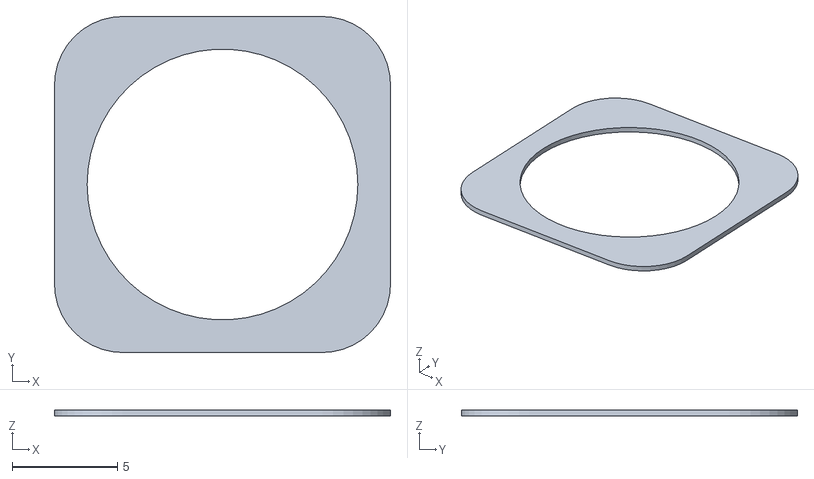
[picture p60: CAD file, 2021-02-06]
YingXao_Mechanical/Printable/Banzi3.stl
16.0 x 16.0 x 0.3
