YilunAllenChen/YingXao/YingXao_Mechanical/Printable/SolarGearDriver_v12.stl

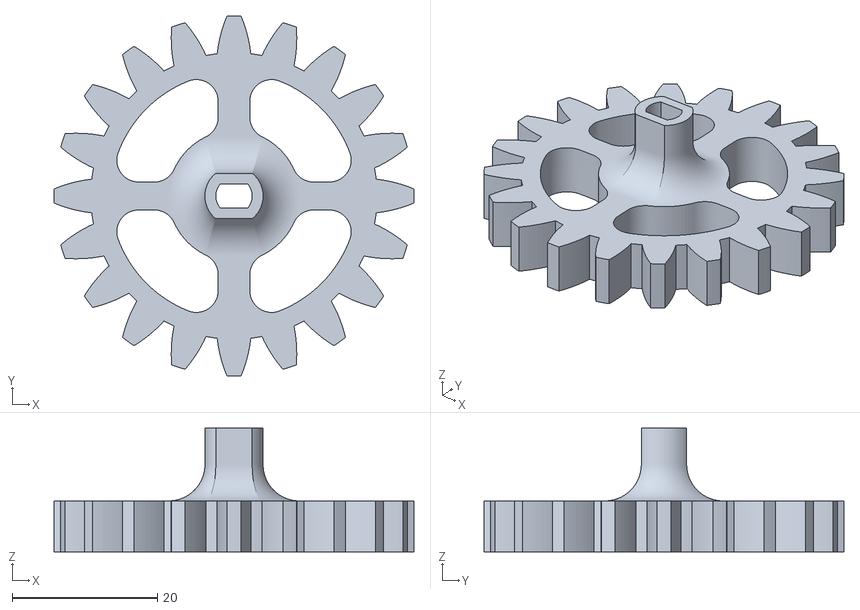
[picture p61: CAD file, 2021-03-14, an earlier design]
YingXao_Mechanical/Printable/SolarGearDriver_v12.stl
49.5 x 49.5 x 17.0
