YilunAllenChen/YingXao/YingXao_Mechanical/Printable/SolarGearRing_v6.stl

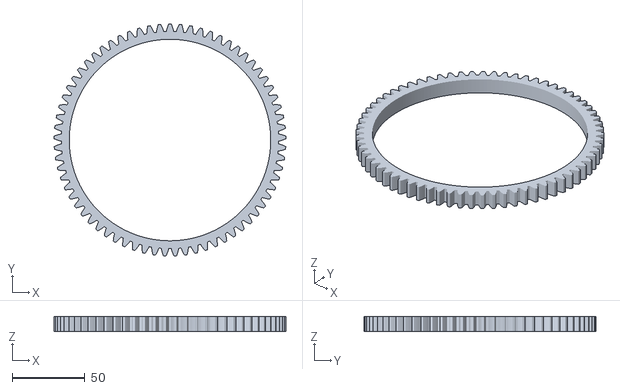
[picture p62: CAD file, 2021-03-02, an earlier design]
YingXao_Mechanical/Printable/SolarGearRing_v6.stl
159.5 x 159.5 x 10.0
