YilunAllenChen/YingXao/YingXao_Mechanical/Printable/SolarGearBearing_v4.stl

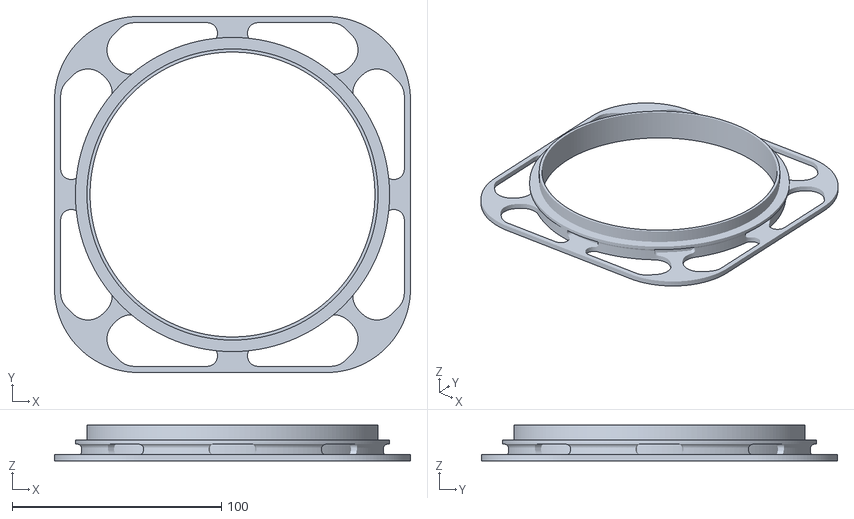
[picture p63: CAD file, 2021-03-02, an earlier design]
YingXao_Mechanical/Printable/SolarGearBearing_v4.stl
170.0 x 170.0 x 17.0
