YilunAllenChen/YingXao/(list of files, cad)

Other CAD files:
YingXao_Mechanical/Printable/SolarGearDriver_v10.stl
YingXao_Mechanical/In Development/MotorMount.ipt
YingXao_Mechanical/In Development/OldVersions/MotorMount.0008.ipt
YingXao_Mechanical/In Development/OldVersions/SolarGearBearing.0015.ipt
YingXao_Mechanical/In Development/OldVersions/SolarGear_v2.0001.iam
YingXao_Mechanical/In Development/OldVersions/SolarGear_v333.0001.iam
YingXao_Mechanical/In Development/OldVersions/SolarGear_v4.0002.iam
YingXao_Mechanical/In Development/OldVersions/SolarGear_v5.0002.iam
YingXao_Mechanical/In Development/OldVersions/SolarPanel.0001.ipt
YingXao_Mechanical/In Development/OldVersions/UniversalMount_v1.0011.ipt
YingXao_Mechanical/In Development/OldVersions/solargear.0007.iam
YingXao_Mechanical/In Development/SolarGearBearing.ipt
YingXao_Mechanical/In Development/SolarGearRingWithBlind.iam
YingXao_Mechanical/In Development/SolarGear_v2.iam
YingXao_Mechanical/In Development/SolarGear_v2/Design Accelerator/OldVersions/Spur Gear11.0003.ipt
YingXao_Mechanical/In Development/SolarGear_v2/Design Accelerator/OldVersions/Spur Gear21.0001.ipt
YingXao_Mechanical/In Development/SolarGear_v2/Design Accelerator/Spur Gear11.ipt
YingXao_Mechanical/In Development/SolarGear_v2/Design Accelerator/Spur Gear21.ipt
YingXao_Mechanical/In Development/SolarGear_v2/Design Accelerator/Spur Gears1.iam
YingXao_Mechanical/In Development/SolarGear_v3.iam
YingXao_Mechanical/In Development/SolarGear_v3/Design Accelerator/OldVersions/Spur Gear11.0001.ipt
YingXao_Mechanical/In Development/SolarGear_v3/Design Accelerator/OldVersions/Spur Gear21.0001.ipt
YingXao_Mechanical/In Development/SolarGear_v3/Design Accelerator/Spur Gear11.ipt
YingXao_Mechanical/In Development/SolarGear_v3/Design Accelerator/Spur Gear21.ipt
YingXao_Mechanical/In Development/SolarGear_v3/Design Accelerator/Spur Gears1.iam
YingXao_Mechanical/In Development/SolarGear_v4.iam
YingXao_Mechanical/In Development/SolarGear_v4/Design Accelerator/OldVersions/Spur Gear11.0001.ipt
YingXao_Mechanical/In Development/SolarGear_v4/Design Accelerator/OldVersions/Spur Gear21.0001.ipt
YingXao_Mechanical/In Development/SolarGear_v4/Design Accelerator/Spur Gear11.ipt
YingXao_Mechanical/In Development/SolarGear_v4/Design Accelerator/Spur Gear21.ipt
YingXao_Mechanical/In Development/SolarGear_v4/Design Accelerator/Spur Gears1.iam
YingXao_Mechanical/In Development/SolarGear_v5.iam
YingXao_Mechanical/In Development/SolarGear_v5/Design Accelerator/OldVersions/Spur Gear11.0008.ipt
YingXao_Mechanical/In Development/SolarGear_v5/Design Accelerator/OldVersions/Spur Gear111.0003.ipt
YingXao_Mechanical/In Development/SolarGear_v5/Design Accelerator/OldVersions/Spur Gear21.0003.ipt
YingXao_Mechanical/In Development/SolarGear_v5/Design Accelerator/OldVersions/Spur Gears1.0001.iam
YingXao_Mechanical/In Development/SolarGear_v5/Design Accelerator/Spur Gear11.ipt
YingXao_Mechanical/In Development/SolarGear_v5/Design Accelerator/Spur Gear111.ipt
YingXao_Mechanical/In Development/SolarGear_v5/Design Accelerator/Spur Gear21.ipt
YingXao_Mechanical/In Development/SolarGear_v5/Design Accelerator/Spur Gears1.iam
YingXao_Mechanical/In Development/SolarPanel.ipt
YingXao_Mechanical/In Development/UniversalMount_v1.ipt
YingXao_Mechanical/In Development/backpack.ipt
YingXao_Mechanical/In Development/solargear.iam
YingXao_Mechanical/In Development/solargear/Design Accelerator/OldVersions/Spur Gear11.0001.ipt
YingXao_Mechanical/In Development/solargear/Design Accelerator/OldVersions/Spur Gear21.0001.ipt
YingXao_Mechanical/In Development/solargear/Design Accelerator/Spur Gear11.ipt
YingXao_Mechanical/In Development/solargear/Design Accelerator/Spur Gear21.ipt
YingXao_Mechanical/In Development/solargear/Design Accelerator/Spur Gears1.iam
YingXao_Mechanical/Printable/MotorMount_v0.stl
YingXao_Mechanical/Printable/MotorMount_v1.stl
YingXao_Mechanical/Printable/MotorMount_v2.stl
YingXao_Mechanical/Printable/SolarGearBearing.stl
YingXao_Mechanical/Printable/SolarGearBearing_v1.stl
YingXao_Mechanical/Printable/SolarGearBearing_v2.stl
YingXao_Mechanical/Printable/SolarGearBearing_v3.stl
YingXao_Mechanical/Printable/SolarGearBearing_v5.stl
YingXao_Mechanical/Printable/SolarGearDriver_v1.stl
YingXao_Mechanical/Printable/SolarGearDriver_v11.stl
YingXao_Mechanical/Printable/SolarGearDriver_v2.stl
YingXao_Mechanical/Printable/SolarGearDriver_v3.stl
YingXao_Mechanical/Printable/SolarGearDriver_v4.stl
YingXao_Mechanical/Printable/SolarGearDriver_v5.stl
YingXao_Mechanical/Printable/SolarGearDriver_v6.stl
YingXao_Mechanical/Printable/SolarGearDriver_v7.stl
YingXao_Mechanical/Printable/SolarGearDriver_v8.stl
YingXao_Mechanical/Printable/SolarGearDriver_v9.stl
YingXao_Mechanical/Printable/SolarGearRing_v1.stl
YingXao_Mechanical/Printable/SolarGearRing_v2.stl
YingXao_Mechanical/Printable/SolarGearRing_v3.stl
YingXao_Mechanical/Printable/SolarGearRing_v4.stl
YingXao_Mechanical/Printable/SolarGearRing_v5.stl
YingXao_Mechanical/Printable/UniversalMount_v1.stl
YingXao_Mechanical/Printable/UniversalMount_v2.stl
YingXao_Mechanical/Printable/UniversalMount_v3.stl
YingXao_Mechanical/Printable/UniversalMount_v4.stl
