YilunAllenChen/YingXao/YingXao_Expo/ece_server_version/assembly.jpg

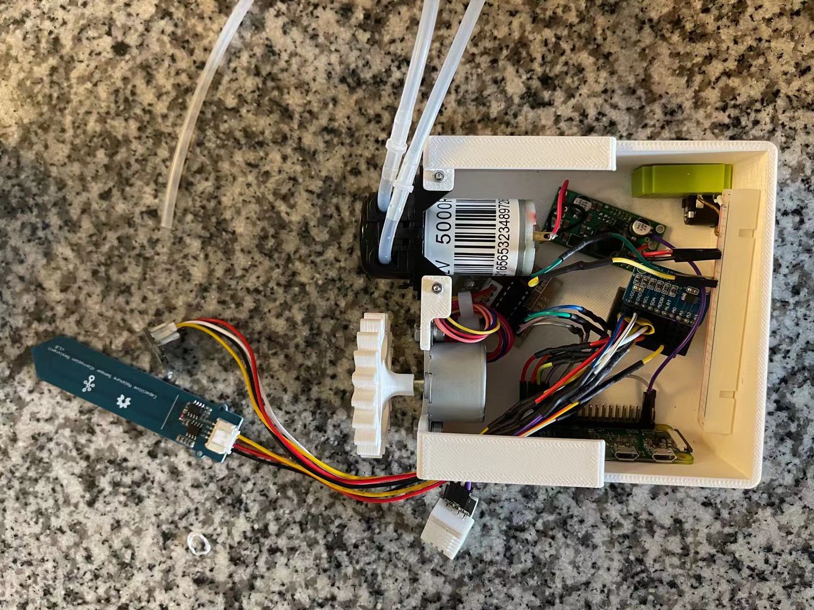
YingXao_Expo/ece_server_version/assembly.jpg
