YilunAllenChen/YingXao/YingXao_Embedded/sensor_dev/stepper.py

import RPi.GPIO as GPIO
import time
 
GPIO.setmode(GPIO.BCM)
GPIO.setwarnings(False)
coil_A_1_pin = 4 # pink
coil_A_2_pin = 17 # orange
coil_B_1_pin = 23 # blue
coil_B_2_pin = 24 # yellow
 
# adjust if different
StepCount = 8
Seq = [x for x in range(StepCount)] 
Seq[0] = [1,0,0,0]
Seq[1] = [1,1,0,0]
Seq[2] = [0,1,0,0]
Seq[3] = [0,1,1,0]
Seq[4] = [0,0,1,0]
Seq[5] = [0,0,1,1]
Seq[6] = [0,0,0,1]
Seq[7] = [1,0,0,1] 

# GPIO.setup(enable_pin, GPIO.OUT)
GPIO.setup(coil_A_1_pin, GPIO.OUT)
GPIO.setup(coil_A_2_pin, GPIO.OUT)
GPIO.setup(coil_B_1_pin, GPIO.OUT)
GPIO.setup(coil_B_2_pin, GPIO.OUT)
 
# GPIO.output(enable_pin, 1)
 
def setStep(w1, w2, w3, w4):
    GPIO.output(coil_A_1_pin, w1)
    GPIO.output(coil_A_2_pin, w2)
    GPIO.output(coil_B_1_pin, w3)
    GPIO.output(coil_B_2_pin, w4)
 
def forward(delay, steps):
# def forward(delay):
    for i in range(steps):
    # while True:
        for j in range(StepCount):
            setStep(Seq[j][0], Seq[j][1], Seq[j][2], Seq[j][3])
            time.sleep(delay)
 
def backward(delay, steps):
    for i in range(steps):
        for j in reversed(range(StepCount)):
            setStep(Seq[j][0], Seq[j][1], Seq[j][2], Seq[j][3])
            time.sleep(delay)

# def turn_clockwise():
#     forward(int(

if __name__ == '__main__':
    # delay = input("Time Delay (ms)?")
    while True:
       delay = input("Time Delay (ms)?")
       # forward(int(delay) / 1000.0)
       steps = input("How many steps forward? ")
       forward(int(delay) / 1000.0, int(steps))
       steps = input("How many steps backwards? ")
       backward(int(delay) / 1000.0, int(steps))
