YilunAllenChen/YingXao/YingXao_Embedded/sensor_dev/time.py

import datetime as dt
import time
import os as o

while True:
    o.system('clear')  
    now = dt.datetime.now()
    current_time = now.strftime("%H:%M:%S")
    print("Current Time = ", current_time)
    print("Current hour = ", now.strftime("%H"))
    if int(now.strftime("%H")) > 6:
        print("It's later than 6 o'clock now")
    
    time.sleep(2.0)
