YilunAllenChen/YingXao/(commit log)

2021-02-06 mechanical parts for backpack and midplate added
    [backpack.ipt, backpack_v0.stl, midplate_v1.stl, midplate_v2.stl, midplate_v3.stl]
2021-02-06 Added SI1145 sunlight sensor library
2021-02-07 added mech design for solargear, solargearbearing and backpack
    [Banzi1.stl, Banzi2.stl, Banzi3.stl, SolarGear.stl, SolarGearBearing.ipt, SolarGearBearing.stl, backpack.ipt, backpack_prototype.stl]
2021-02-07 moved solargearbearning printable part
    [SolarGearBearing.stl]
2021-02-08 feat: mechanical parts
    MotorMount: v0, v1
    SolarGearBearing: v1
    SolarGearDriver: v1, v2, v3
    SolarGearRing: v1, v2, v3
    [MotorMount.0006.ipt, MotorMount.ipt, MotorMount_v0.stl, MotorMount_v1.stl, SolarGearBearing.0002.ipt, SolarGearBearing.ipt, SolarGearBearing_v1.stl, SolarGearDriver_v1.stl]
2021-02-09 feat: mechanical parts
    MotorMount: v2, v3
    SolarGearDriver: v4, v5
    SolarGearRing: v4
    [MotorMount.0006.ipt, MotorMount.0008.ipt, MotorMount.ipt, MotorMount_v2.stl, MotorMount_v3.stl, SolarGearDriver_v4.stl, SolarGearDriver_v5.stl, SolarGearRing_v4.stl]
2021-02-10 step motor init
2021-02-13 Create DHT22Dependency.txt
    The file helps how to set up DHT22 sensor reading
2021-02-27 moisture sensor init
2021-02-27 add firebase library and integrated sensor libraries
2021-03-02 web page added
    [SolarGearBearing.0002.ipt, SolarGearBearing.0013.ipt, SolarGearBearing.ipt, SolarGearBearing_v2.stl, SolarGearBearing_v3.stl, SolarGearBearing_v4.stl, SolarGearBearing_v5.stl, SolarGearDriver_v10.stl]
2021-03-04 web framework updated
2021-03-13 update step motor lib
2021-03-13 alternative moisture sensor
2021-03-13 sensor test file init
2021-03-13 update sensor test file
2021-03-13 water pump lib init
2021-03-13 update pump lib
2021-03-14 added pump test
2021-03-14 download page added
    [SolarGearBearing.0013.ipt, SolarGearBearing.0015.ipt, SolarGearBearing.ipt, SolarGearBearing_v6.stl, SolarGearDriver_v12.stl, SolarGearDriver_v13.stl, SolarGearRingWithBlind.iam, SolarGearRingWithBlind.stl]
2021-03-20 update DHT22 lib and comment out pump control
2021-03-27 added water pump control based on moisture level
2021-04-03 upload sensor data and get sunlight info from database
2021-04-04 updated water pump logic
2021-04-06 fix for button
2021-04-19 update stepper motor steps and dht22 delay
